tristanvandeweg/z80/z80/Plots/pcb/pcbProgress.png

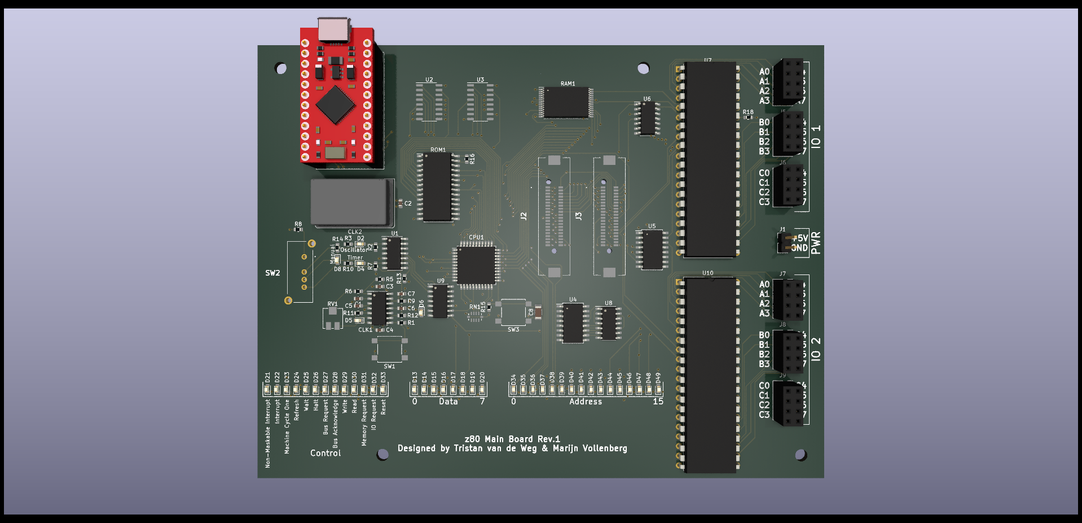
z80/Plots/pcb/pcbProgress.png
