tristanvandeweg/z80/README.md

# z80

Our awesome z80 computer!
<br />
# This project is still a work in progress
