tristanvandeweg/z80/img/pyprogui.png

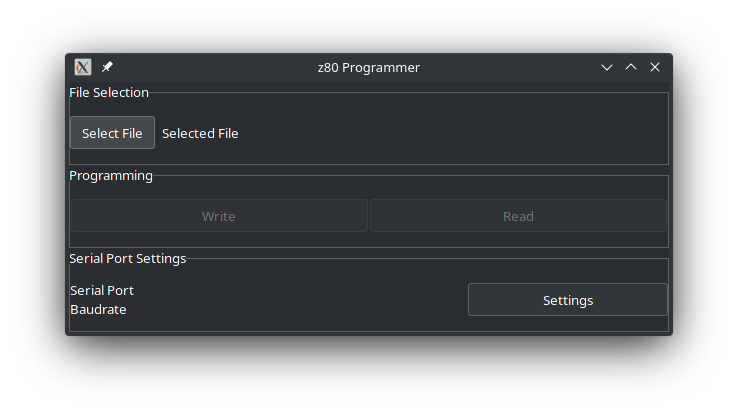
img/pyprogui.png
