tristanvandeweg/z80/img/pyprogui_readout.png

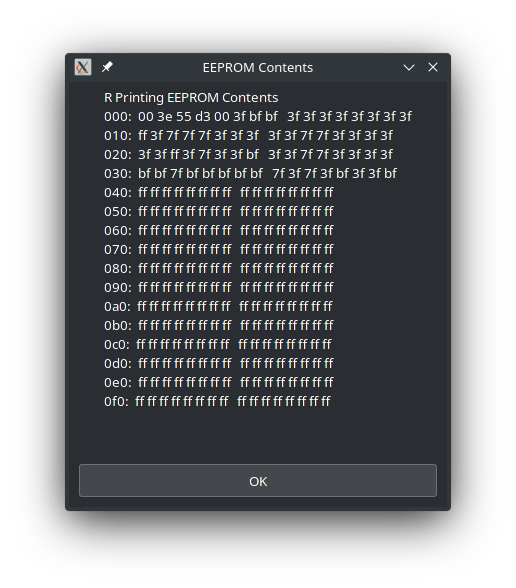
img/pyprogui_readout.png
