tristanvandeweg/z80/img/pyprogui_settings.png

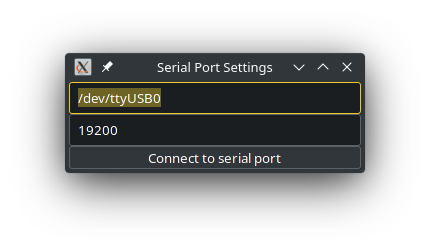
img/pyprogui_settings.png
