tristanvandeweg/z80/src/asm/test/.ticks_history.txt

reg
help
reg
quit
reg
stepi
reg
stepi
reg
stepi
reg
stepi
reg
quit
reg
stepi
reg
stepi
reg
stepi
reg
stepi
reg
stepi
reg
quit
reg
quit
reg
help
set a 36
set b 1f
reg
set a $36
reg
set b $1f
reg
stepi
reg
quit
set a $36
set b $1f
stepi
reg
quit
reg
quit
reg
quit
set b $36
set c $1f
stepi
reg
stepi
reg
stepi
reg
stepi
reg
quit
help
profiler -i
backtrace
stepi
backtrace
frame
frame 1
help
quit
reg
stepi
reg
stepi
reg
quit
reg
quit
nexti
reg
quit
nexti
reg
nexti
quit
nexti
reg
nexti
reg
nexti
reg
quit
reg
stepi
reg
quit
reg
help
x 0000
quit
x
