tristanvandeweg/z80/z80/Plots/schematic/z80.pdf

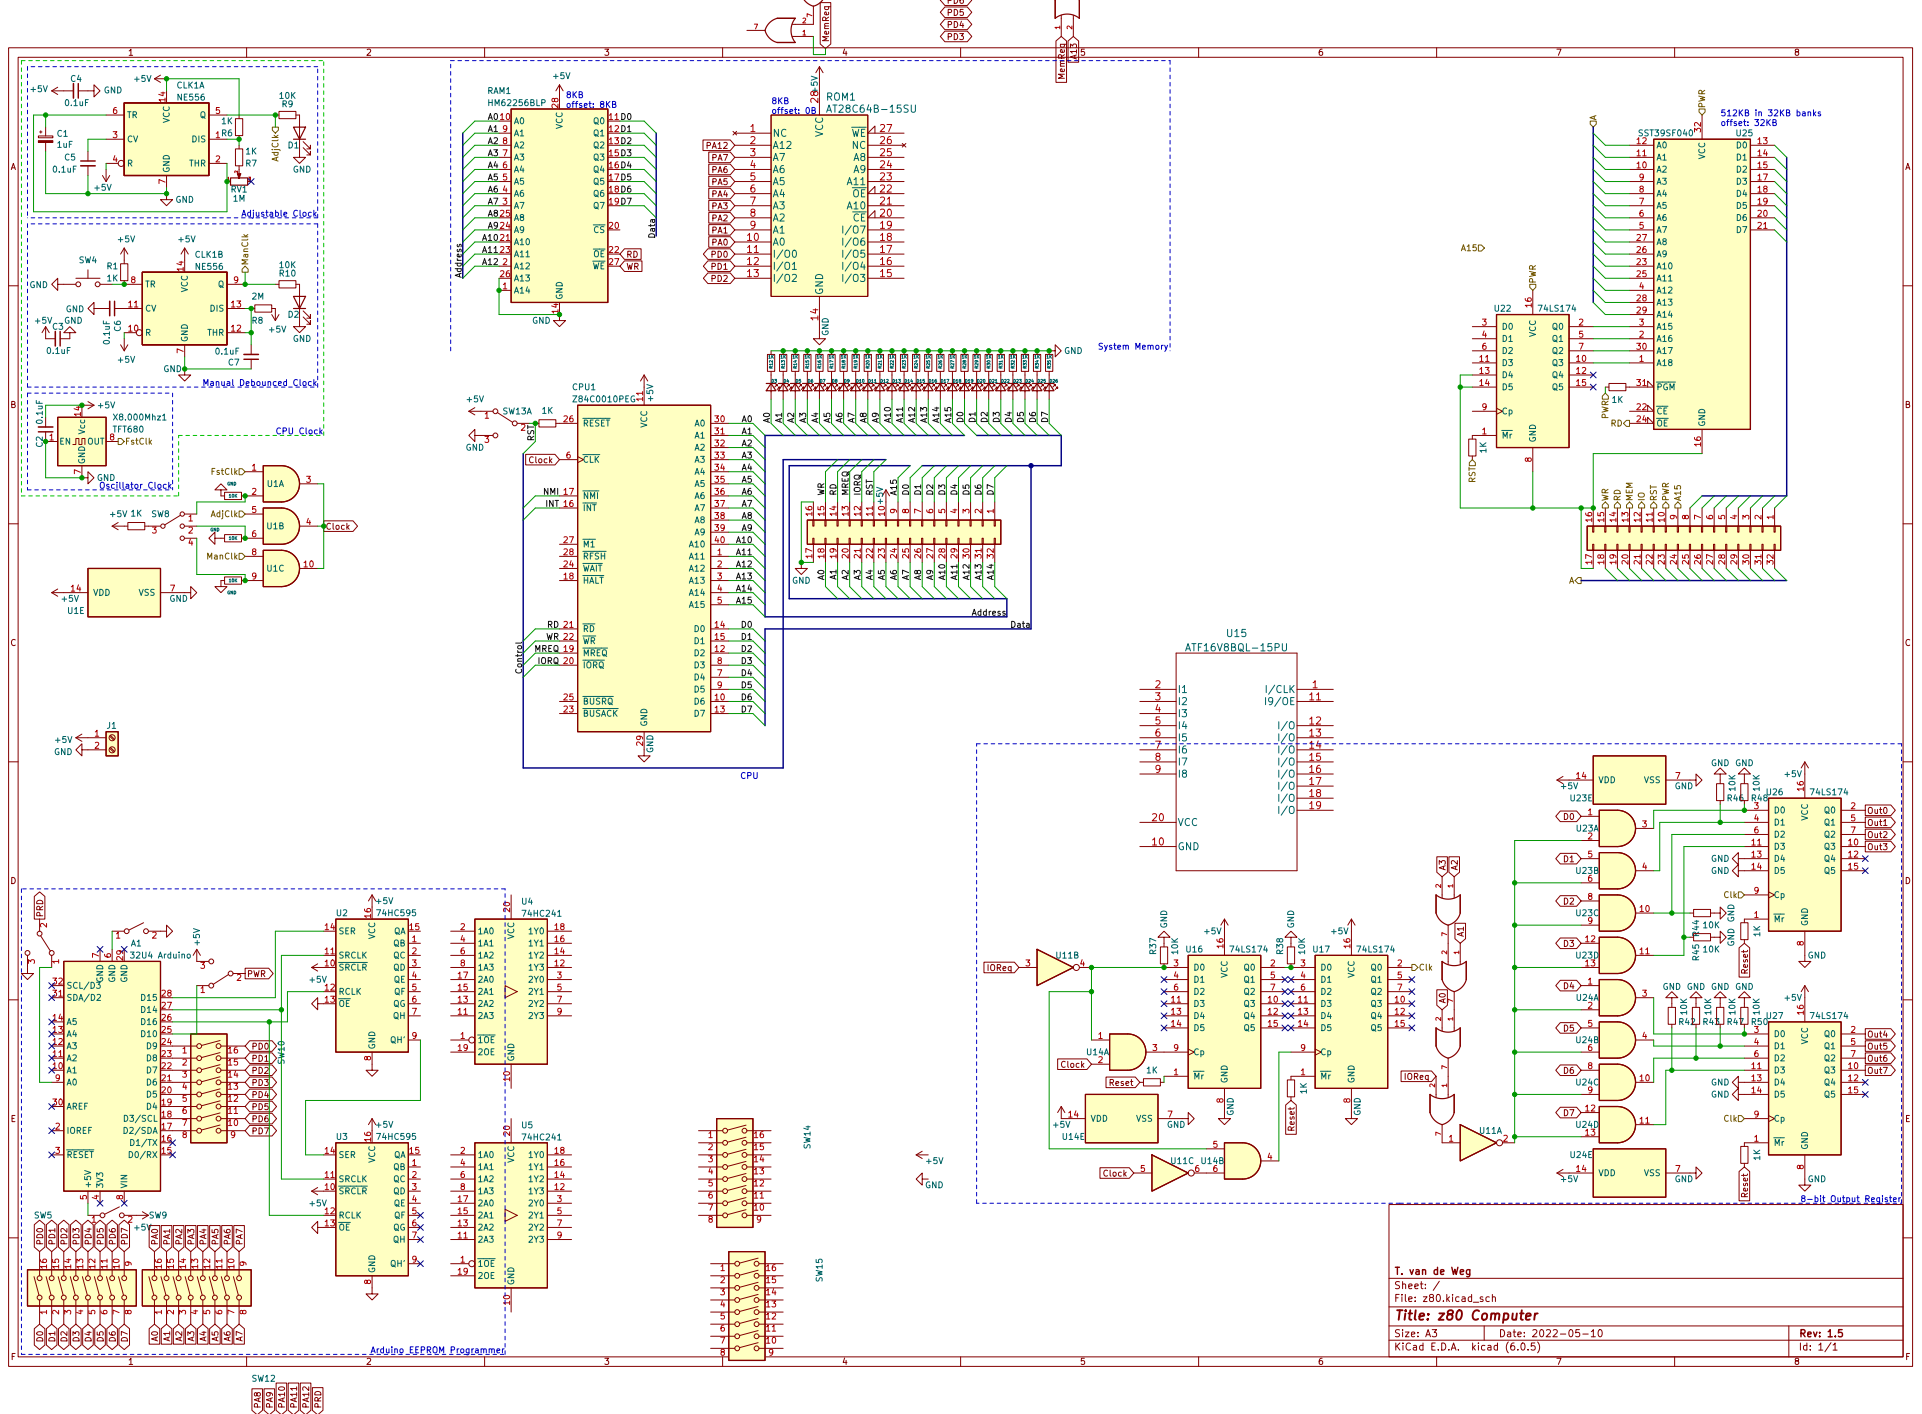
[picture p5: page 1]

1K GND
offset: 8KB CPU Clock Oscillator Clock

Manual Debounced Clock Clock Switching

5 | 12
6 | 11
7 | 10

File: z80.kicad_sch Sheet: / T. van de Weg
