tristanvandeweg/z80/z80/Plots/schematic/z80 (2.0).pdf

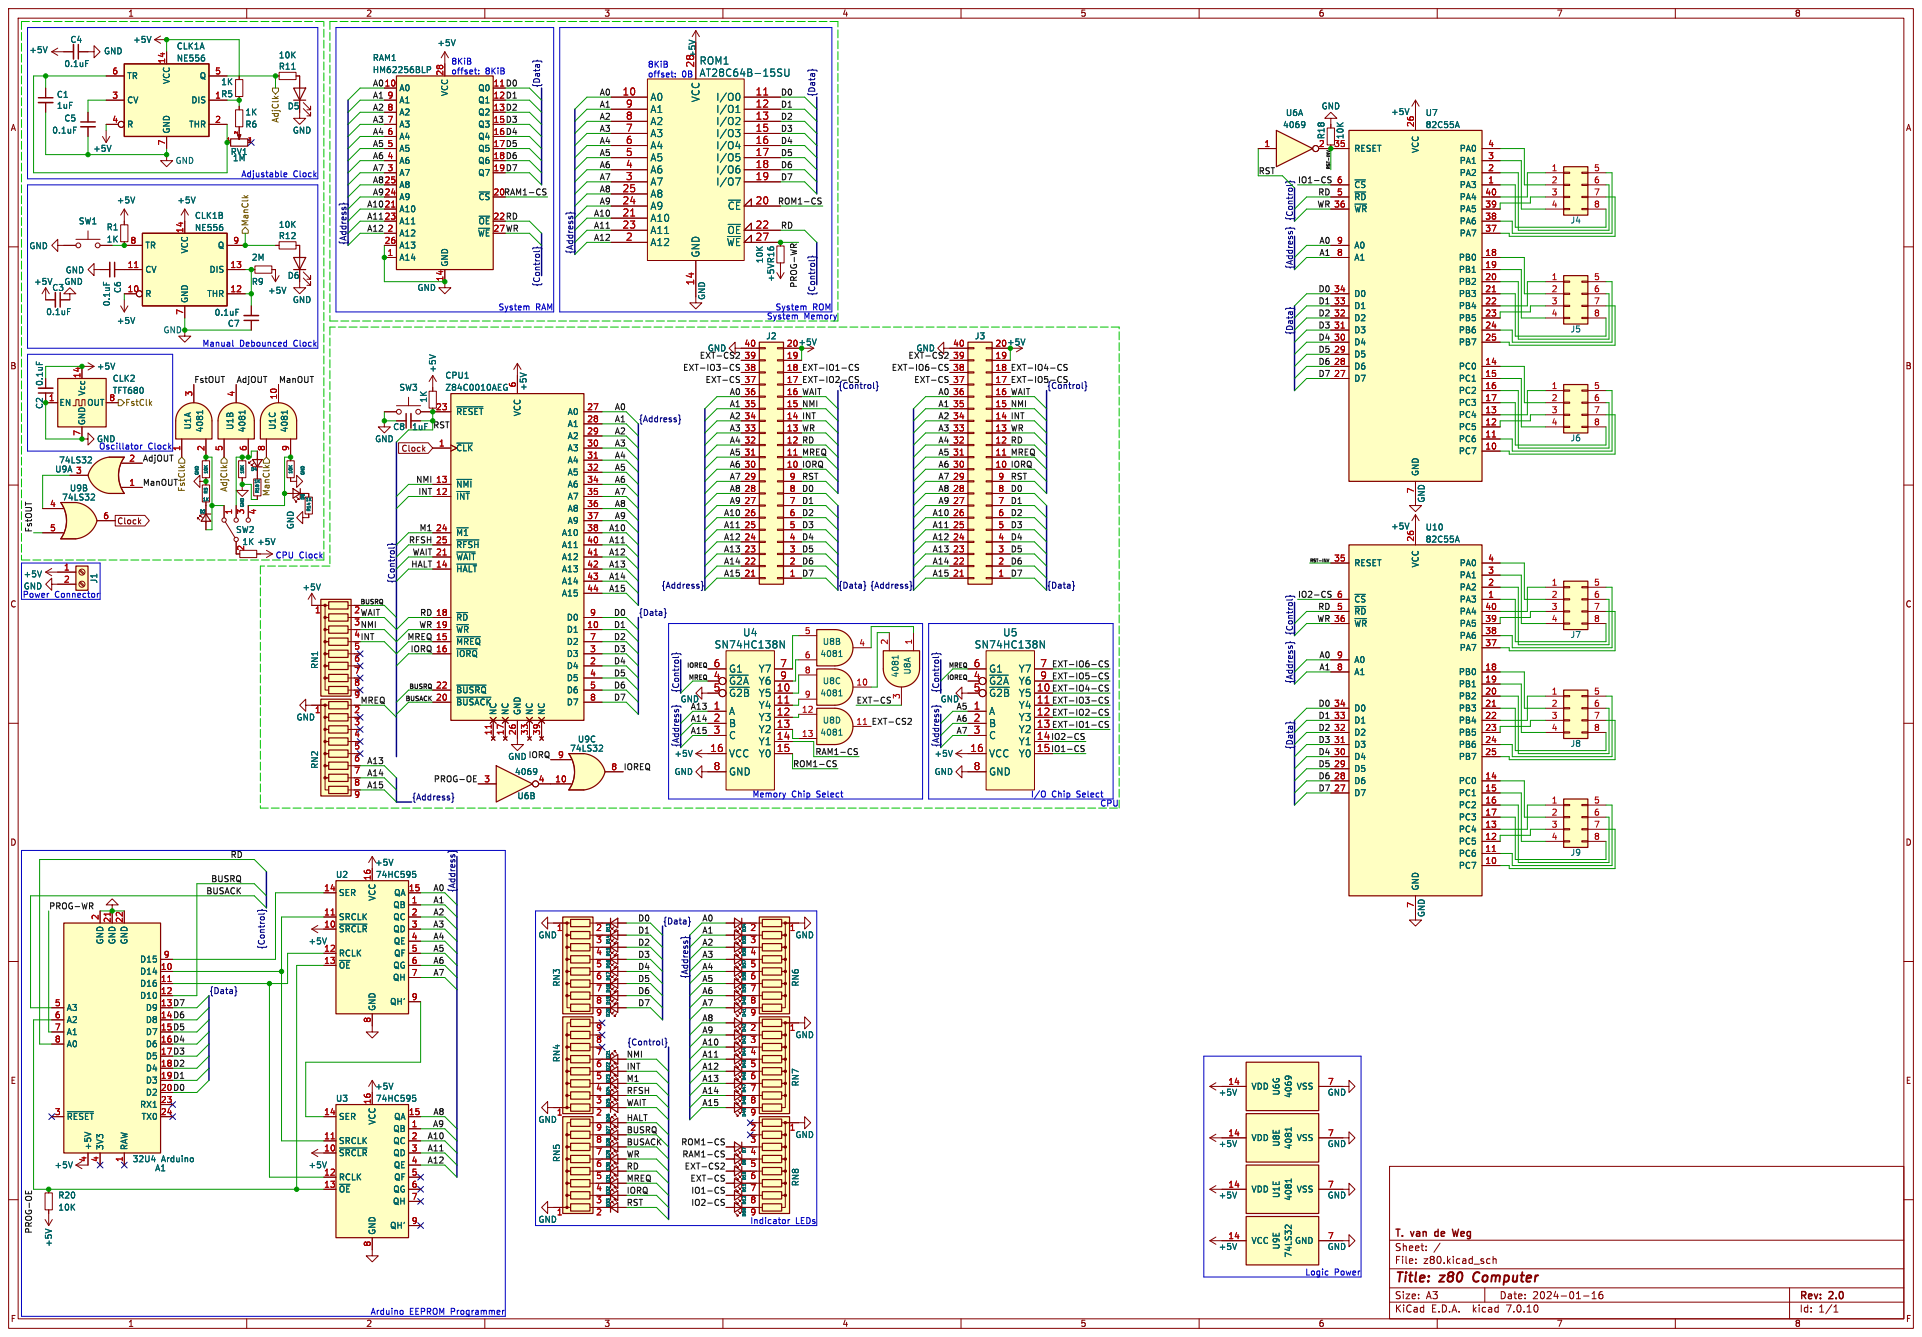
[picture p6: page 1]

CPU1 Z84C0010AEG
RST RFSH WAIT NMI
