tristanvandeweg/z80/z80/Plots/schematic/z80(1.9).pdf

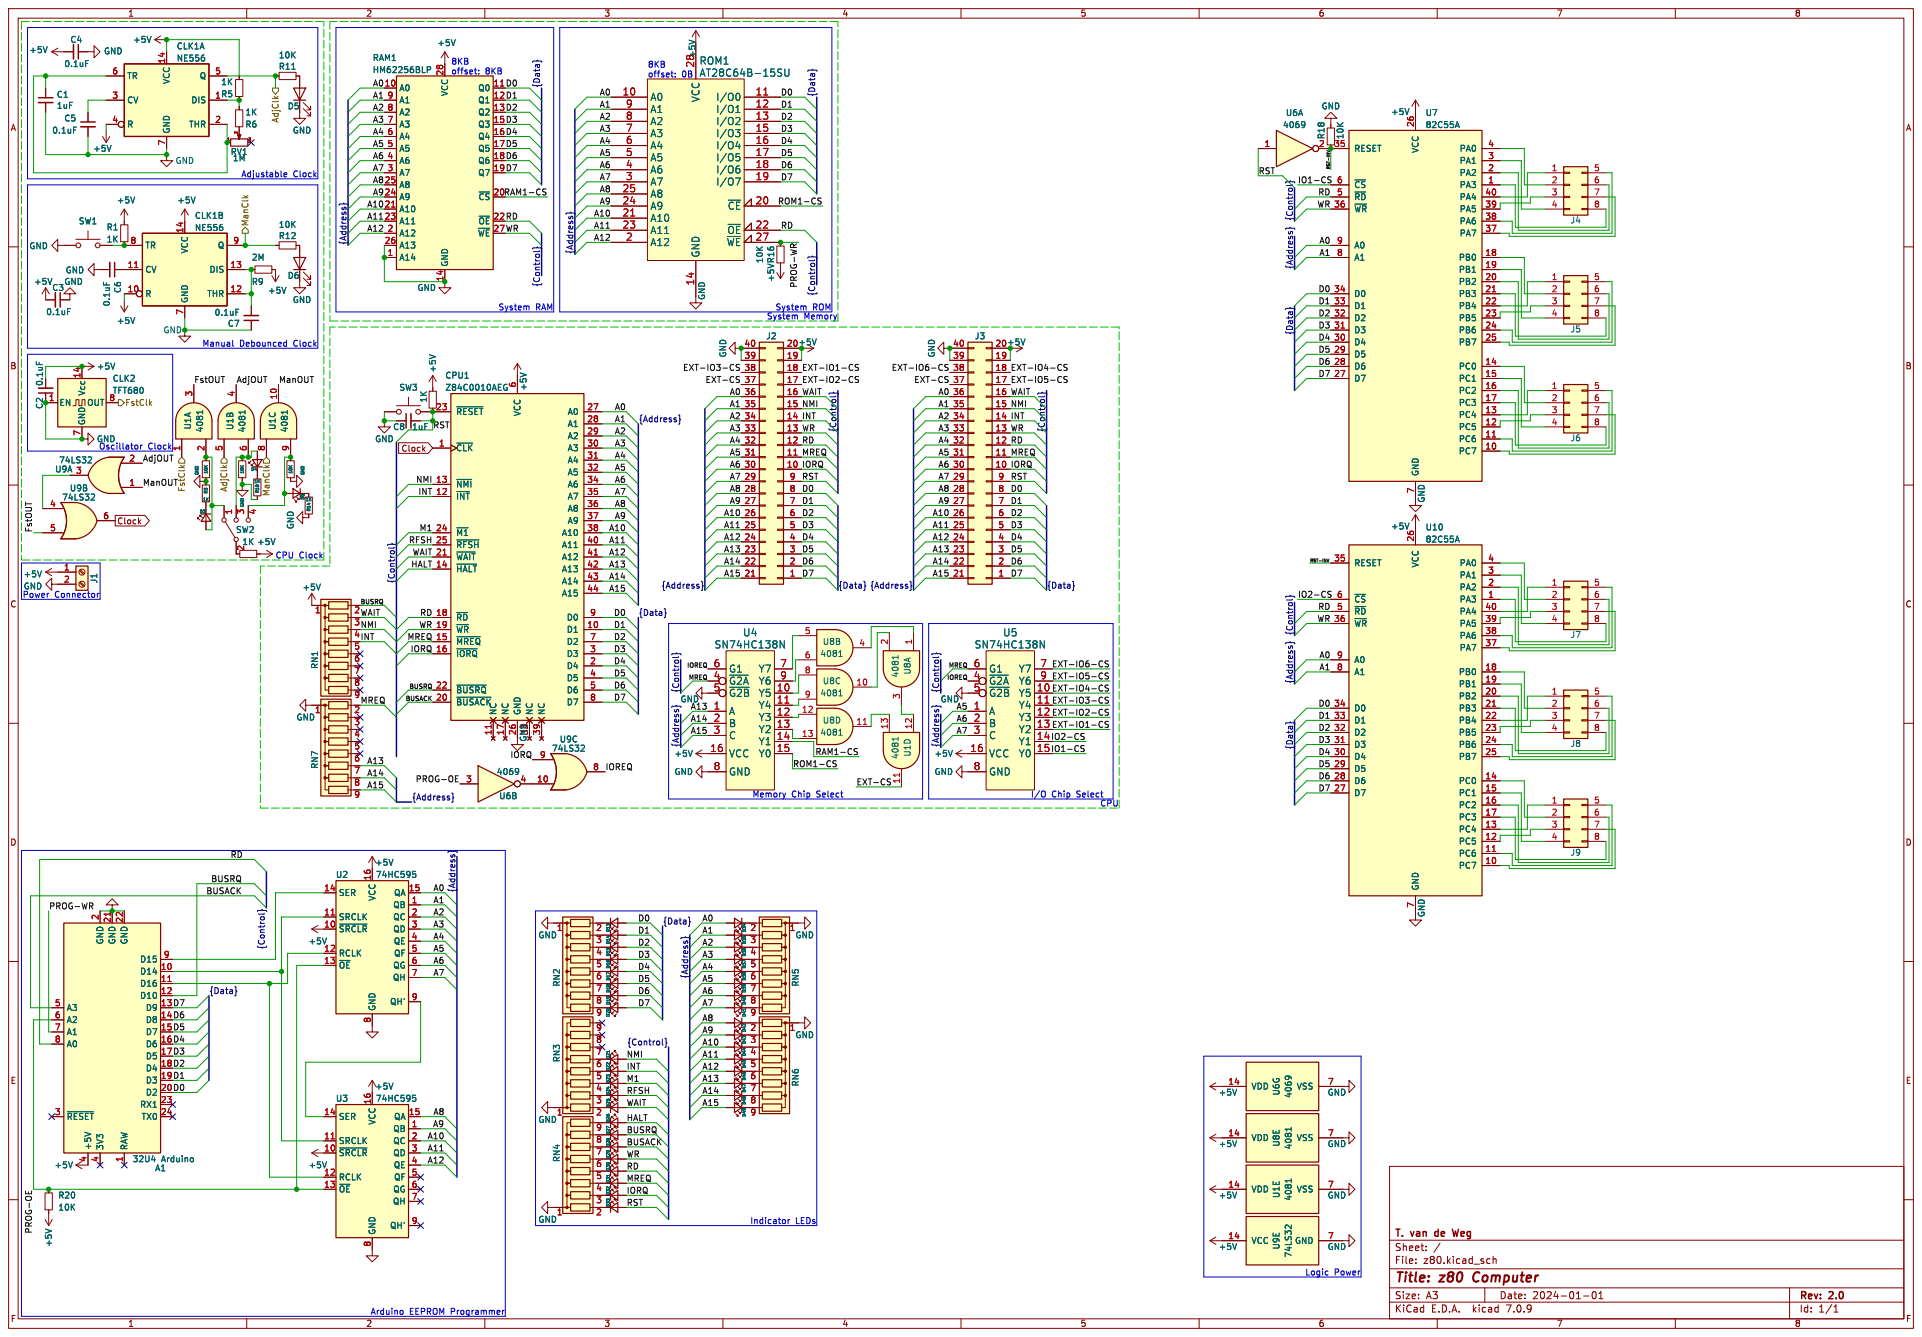
[picture p7: page 1]
