tristanvandeweg/z80/z80/Plots/schematic/output.pdf

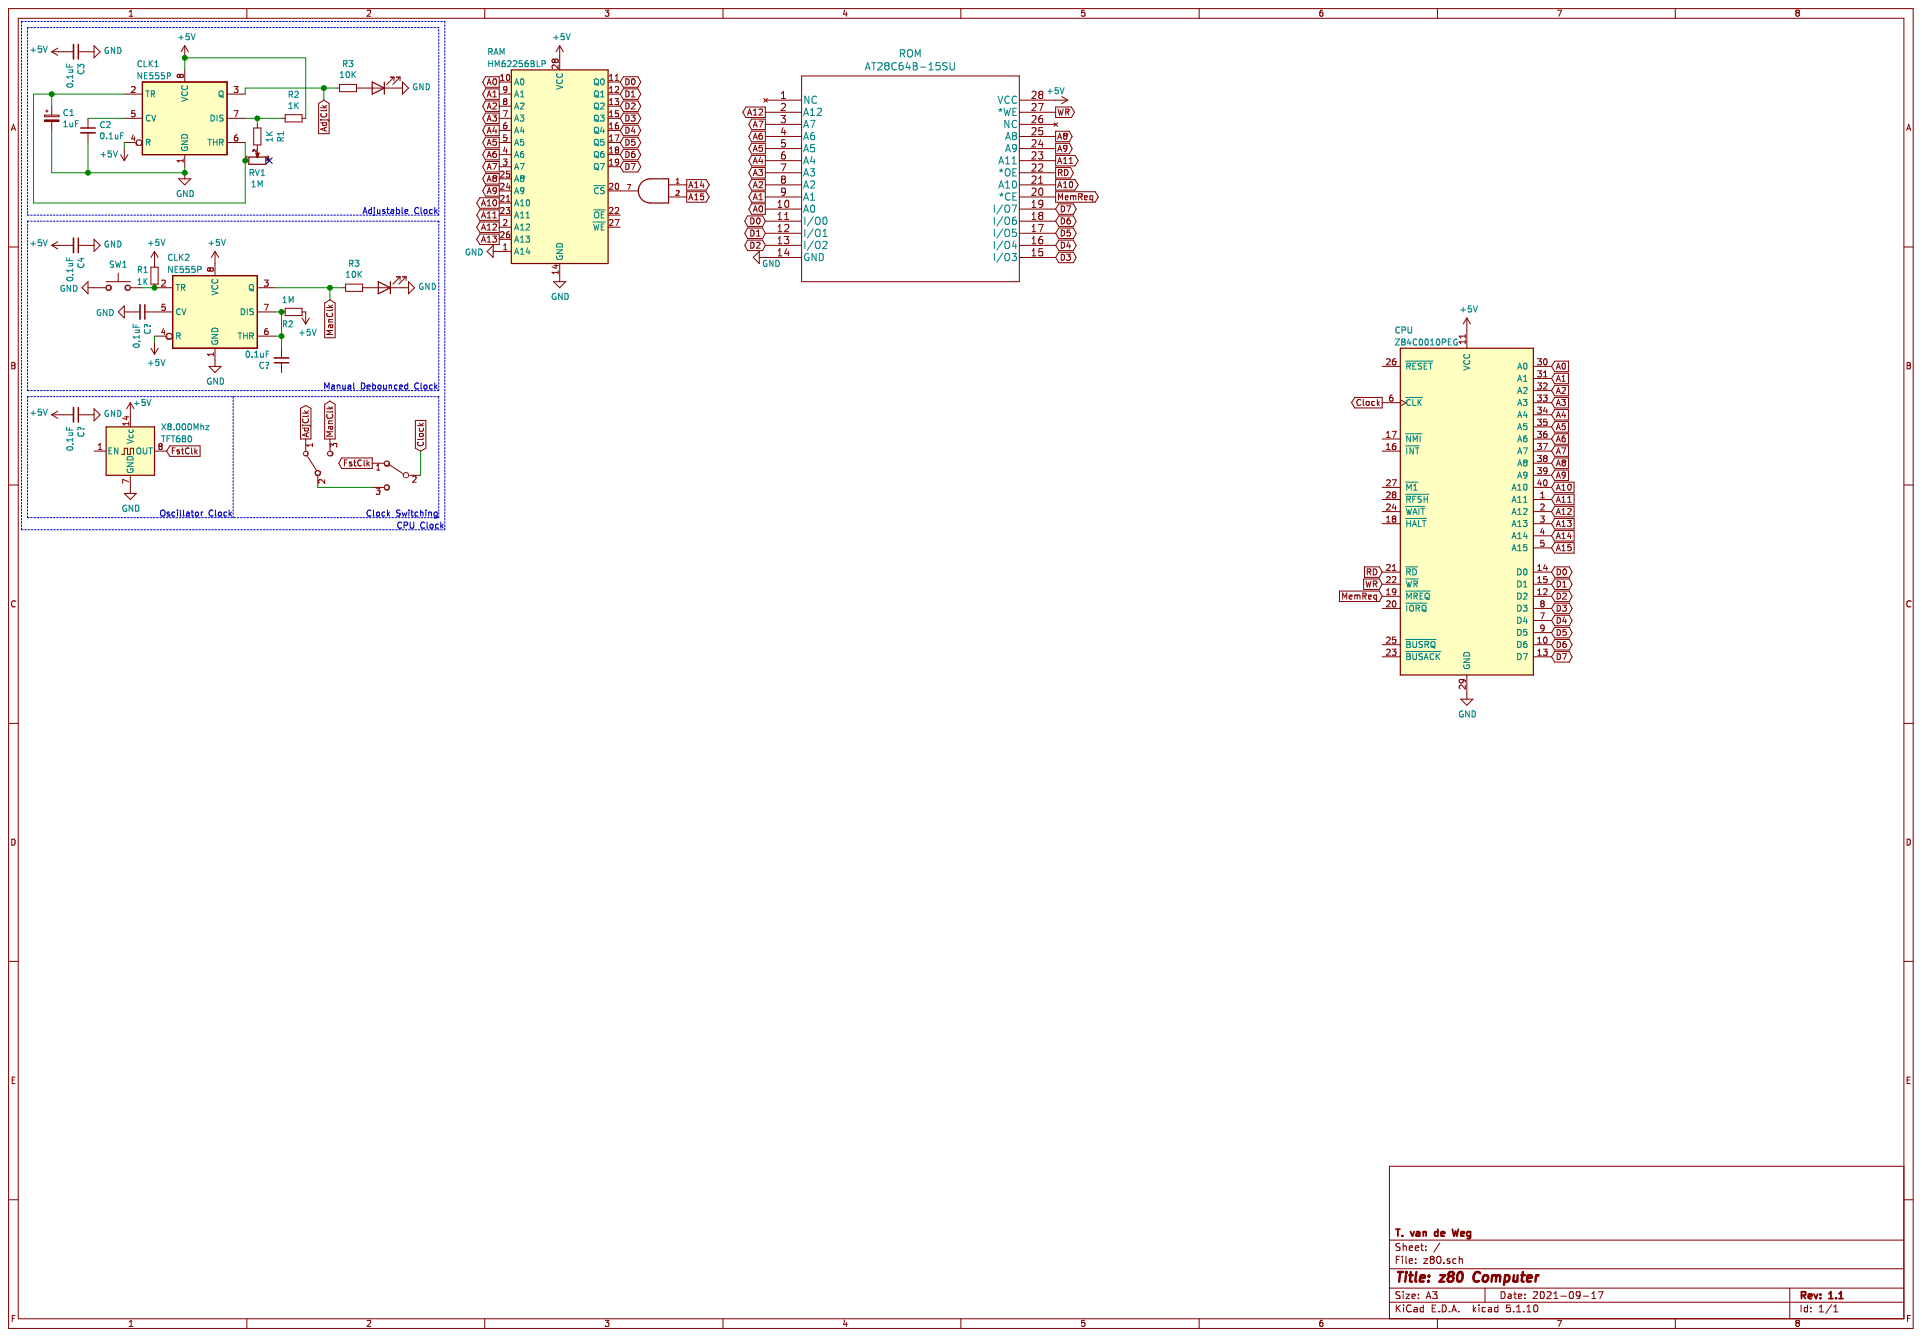
[picture p8: page 1]
