tristanvandeweg/z80/z80/Plots/schematic/z80Computer-v0.1-v1.1.pdf

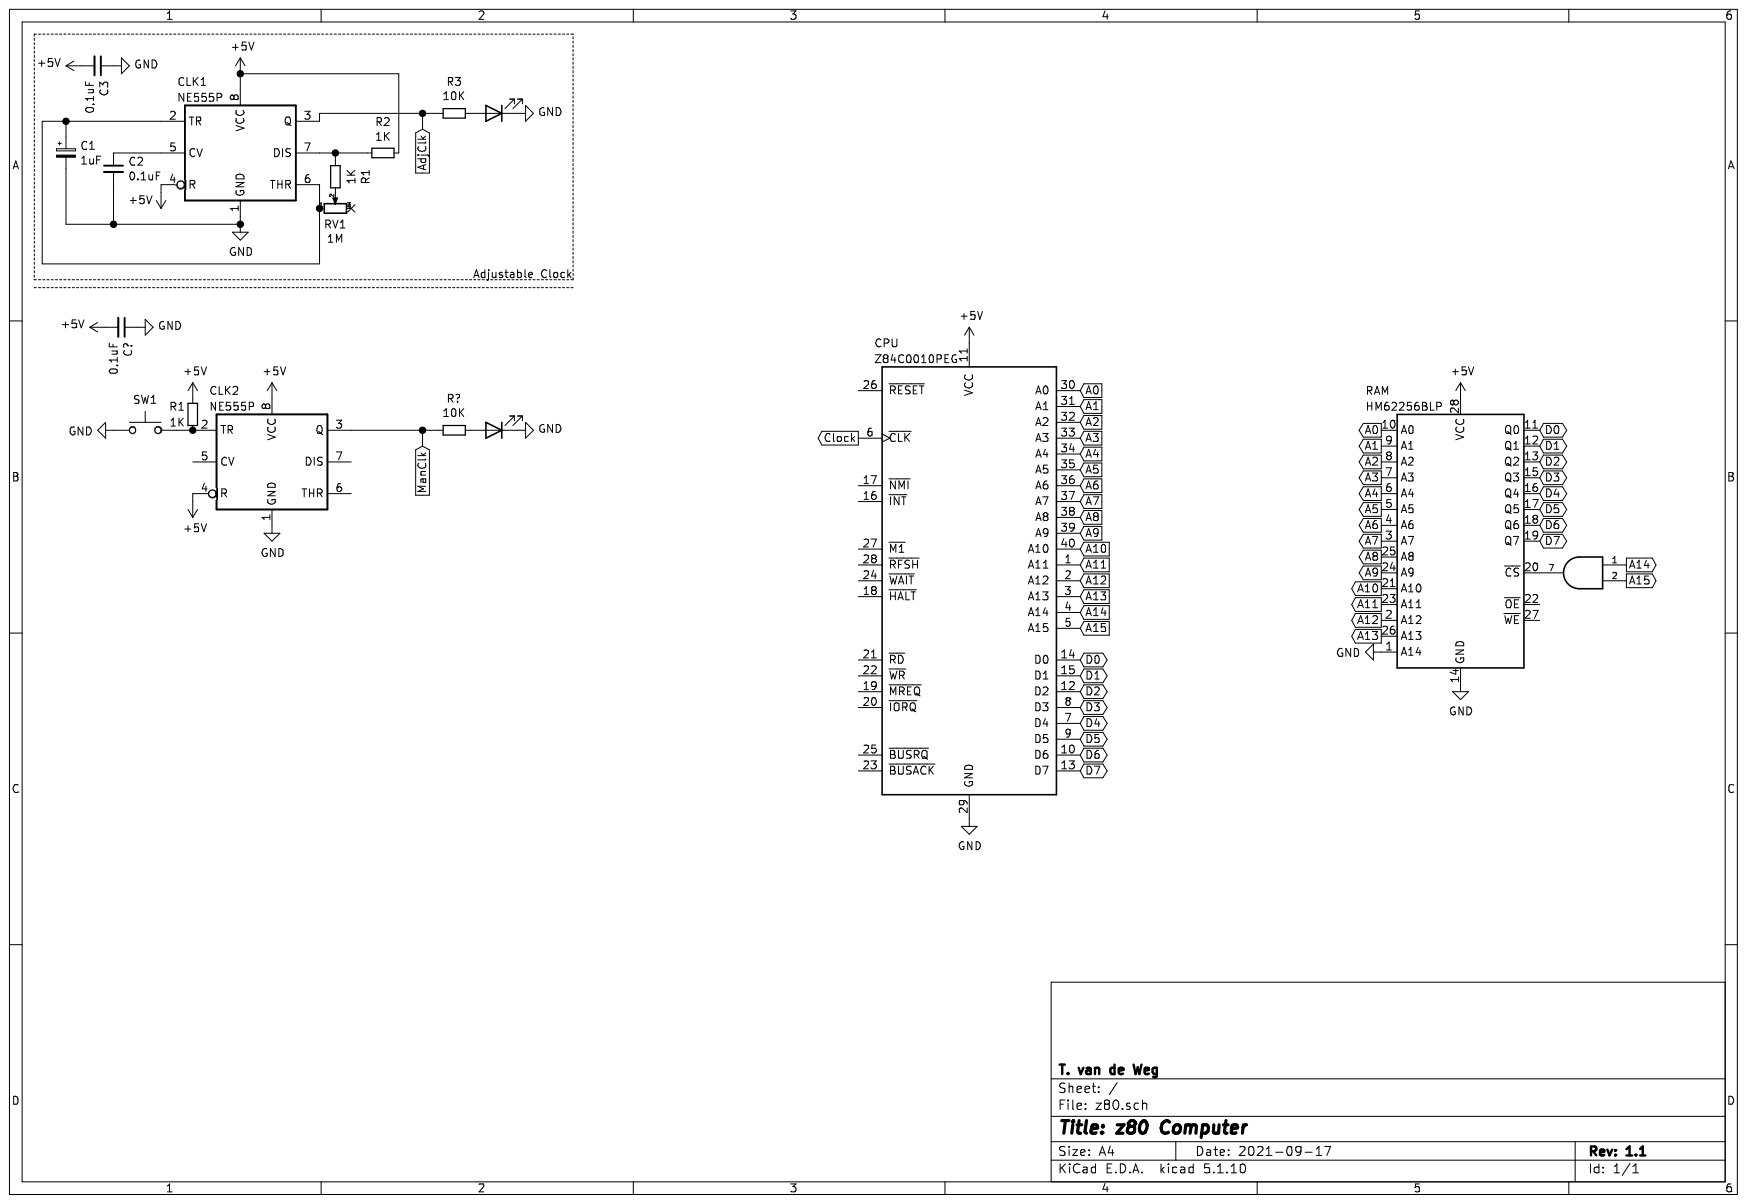
[picture p9: page 1]
