tristanvandeweg/z80/z80/Plots/schematic/z80Computer-v0.2.pdf

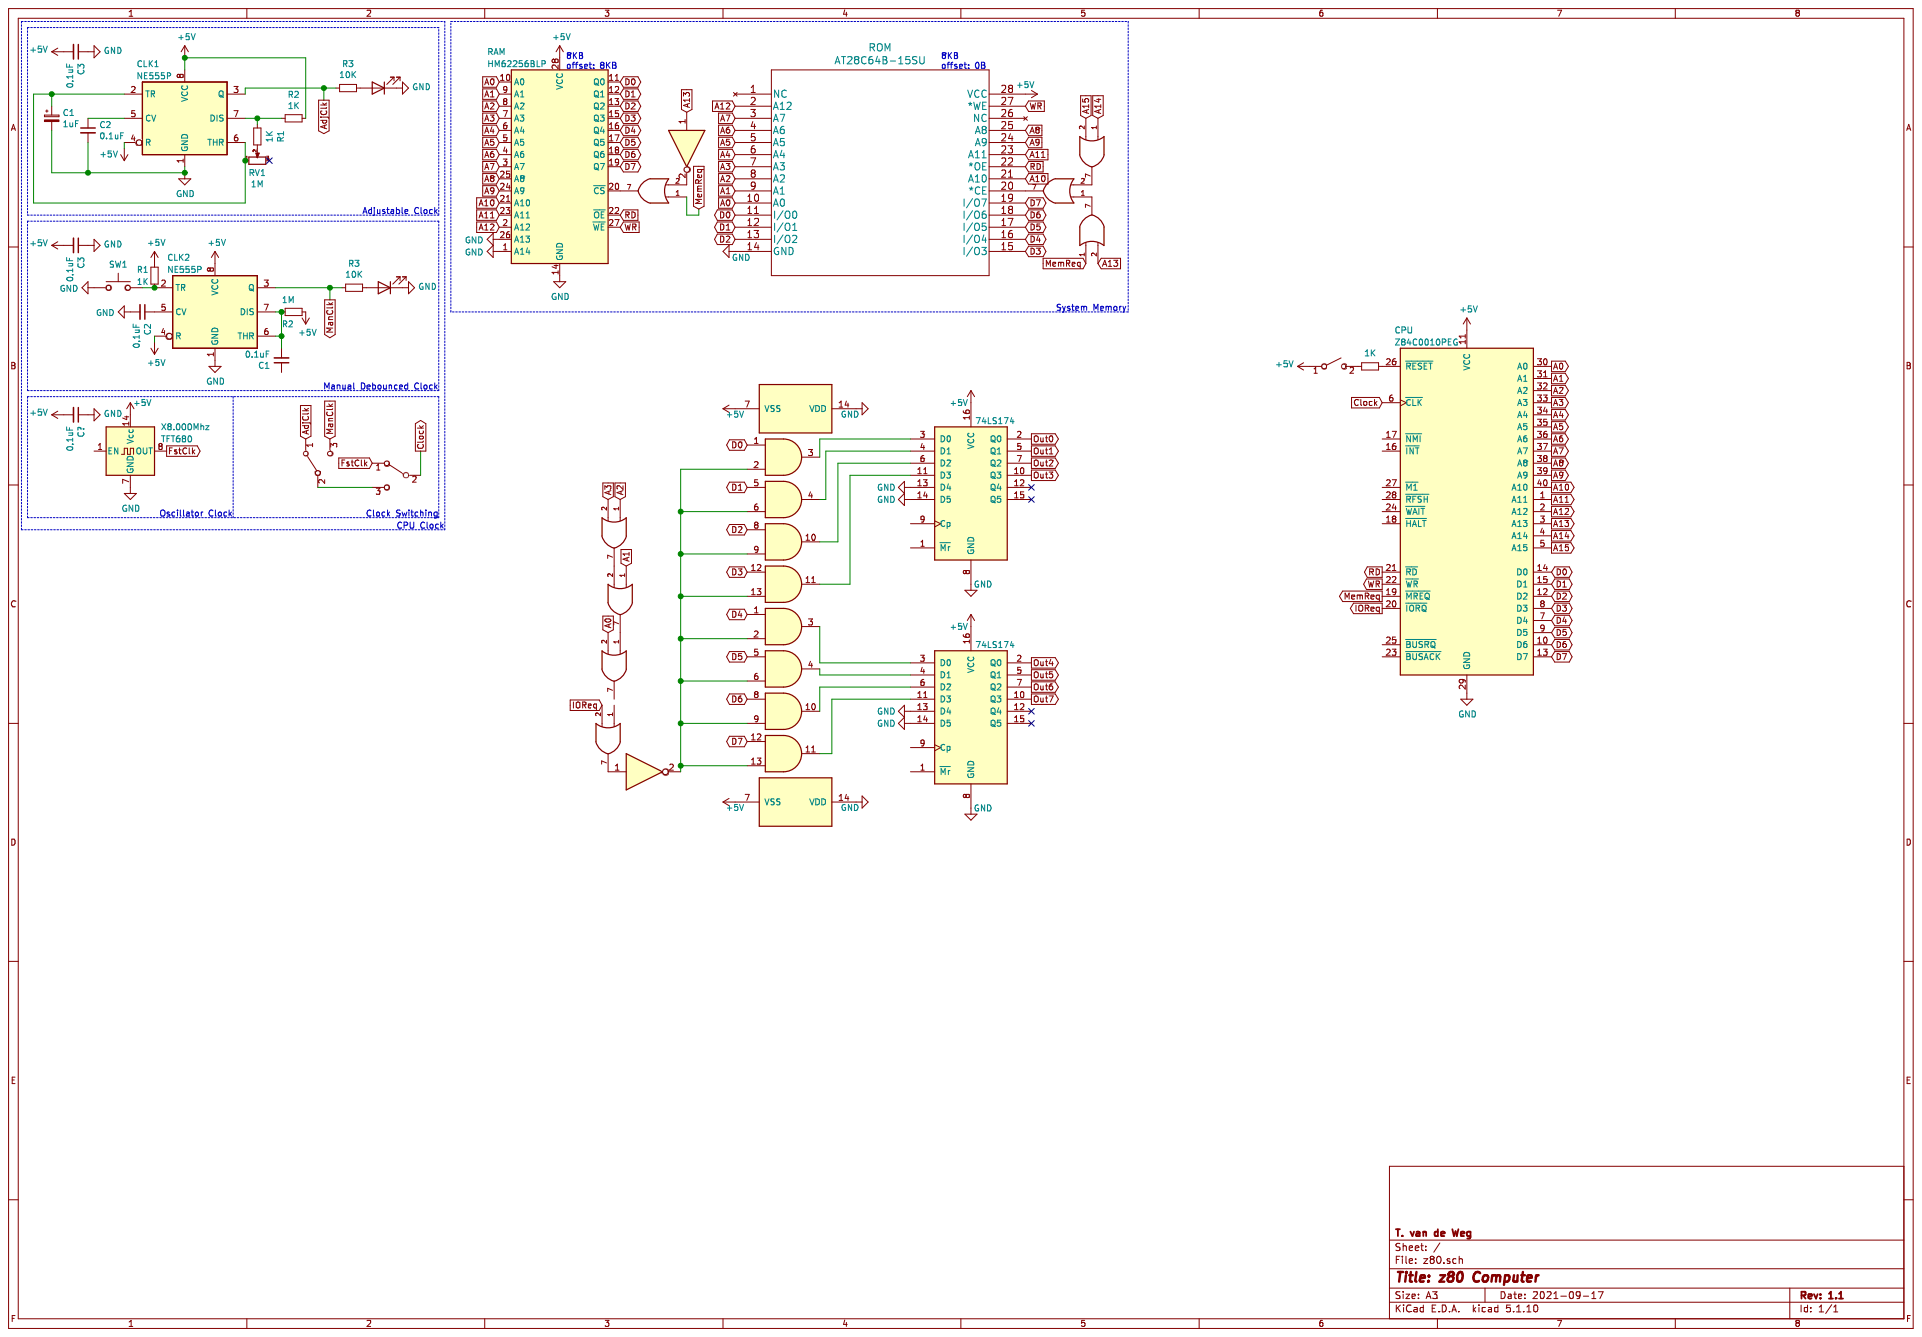
[picture p10: page 1]
