tristanvandeweg/z80/z80/Plots/schematic/z80R1.0Clk.pdf

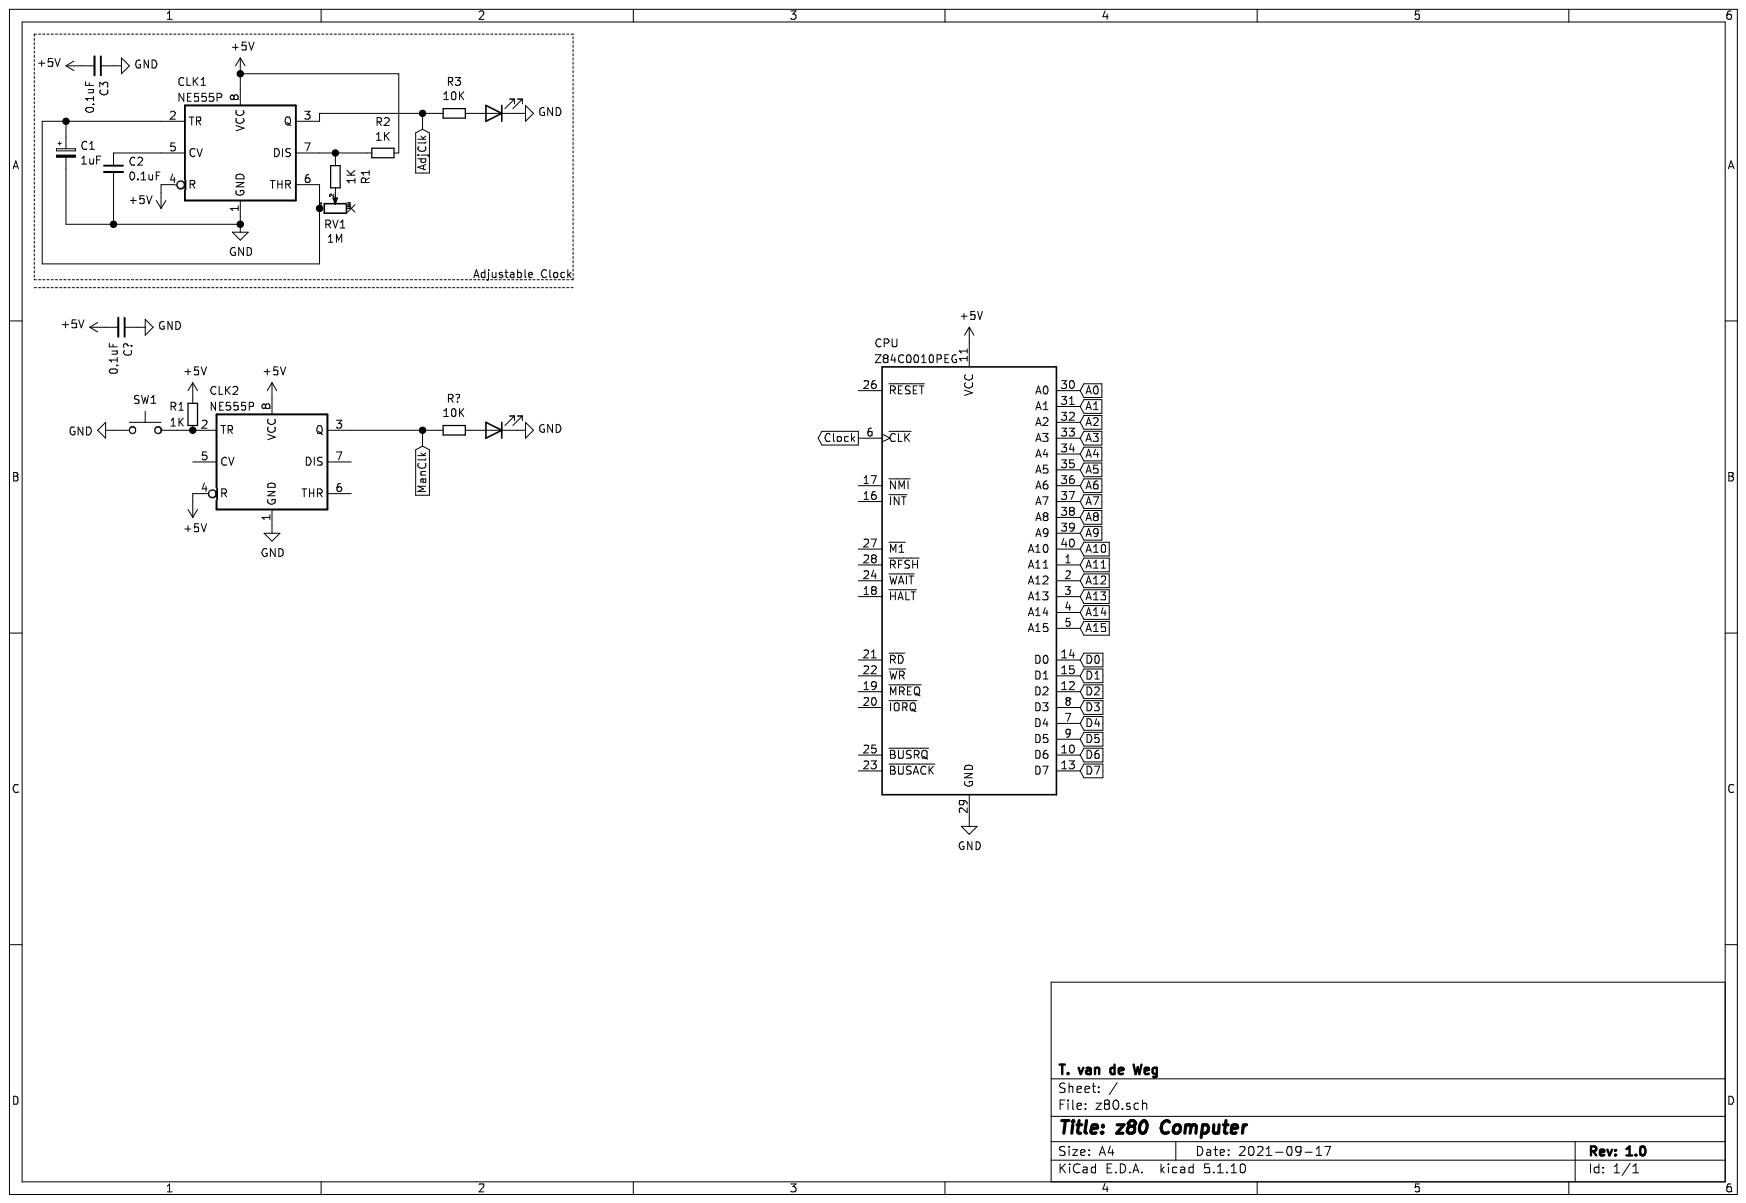
[picture p11: page 1]
