tristanvandeweg/z80/z80/Plots/schematic/z80 (1).pdf

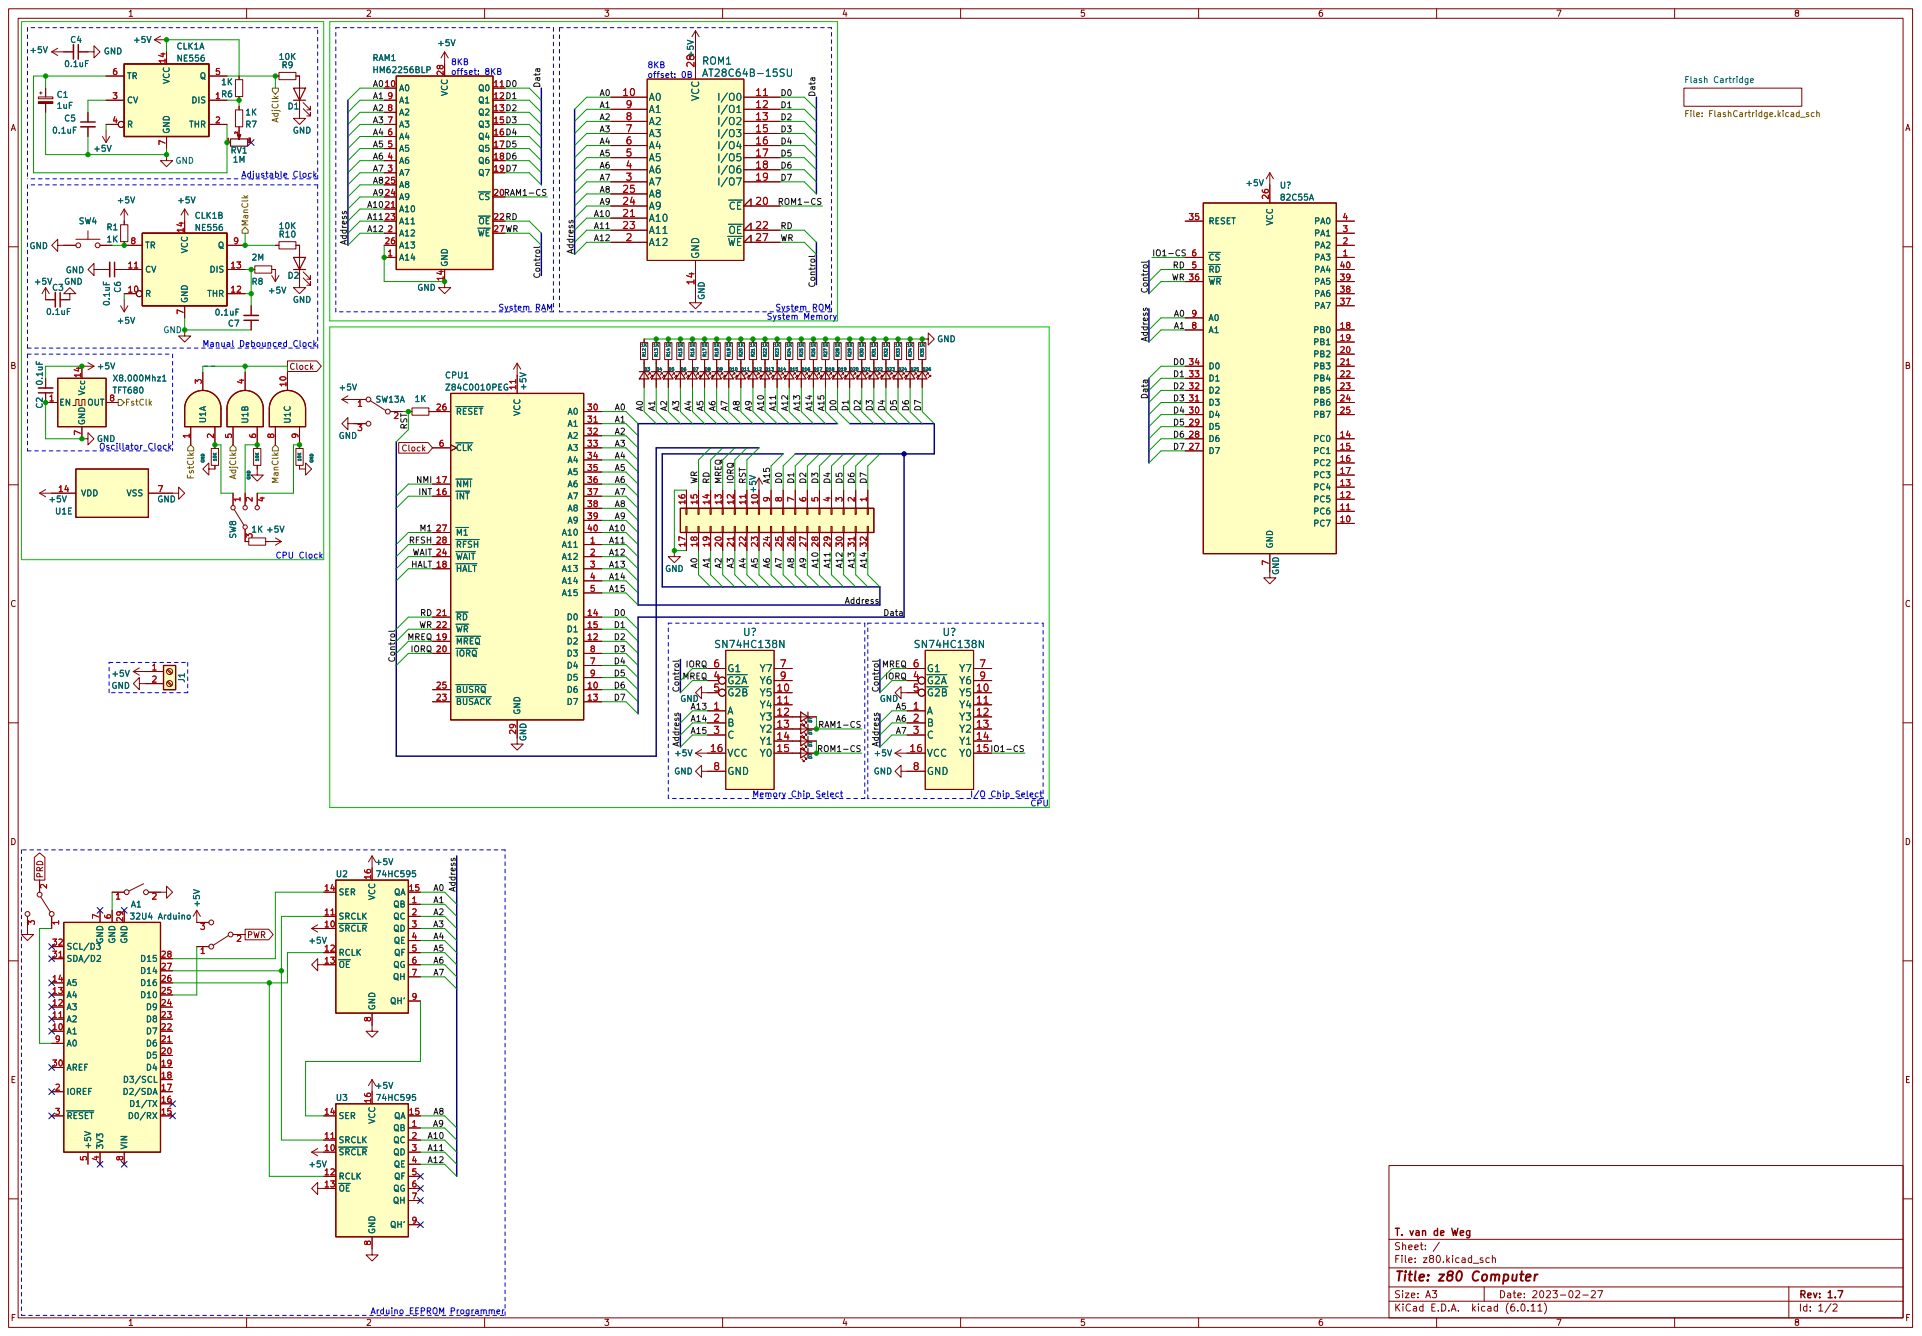
[picture p12: page 1]

Flash Cartridge File: FlashCartridge.kicad_sch R24
25 VCC 26 D7

I/O Chip Select Arduino EEPROM Programmer

Id: 1/2 Title: z80 Computer File: z80.kicad_sch Sheet: / T. van de Weg
