tristanvandeweg/z80/z80/Peripherals/ROM_Card/ROM_Card.kicad_pcb

## KiCad design z80/Peripherals/ROM_Card/ROM_Card.kicad_pcb (2024-03-15)

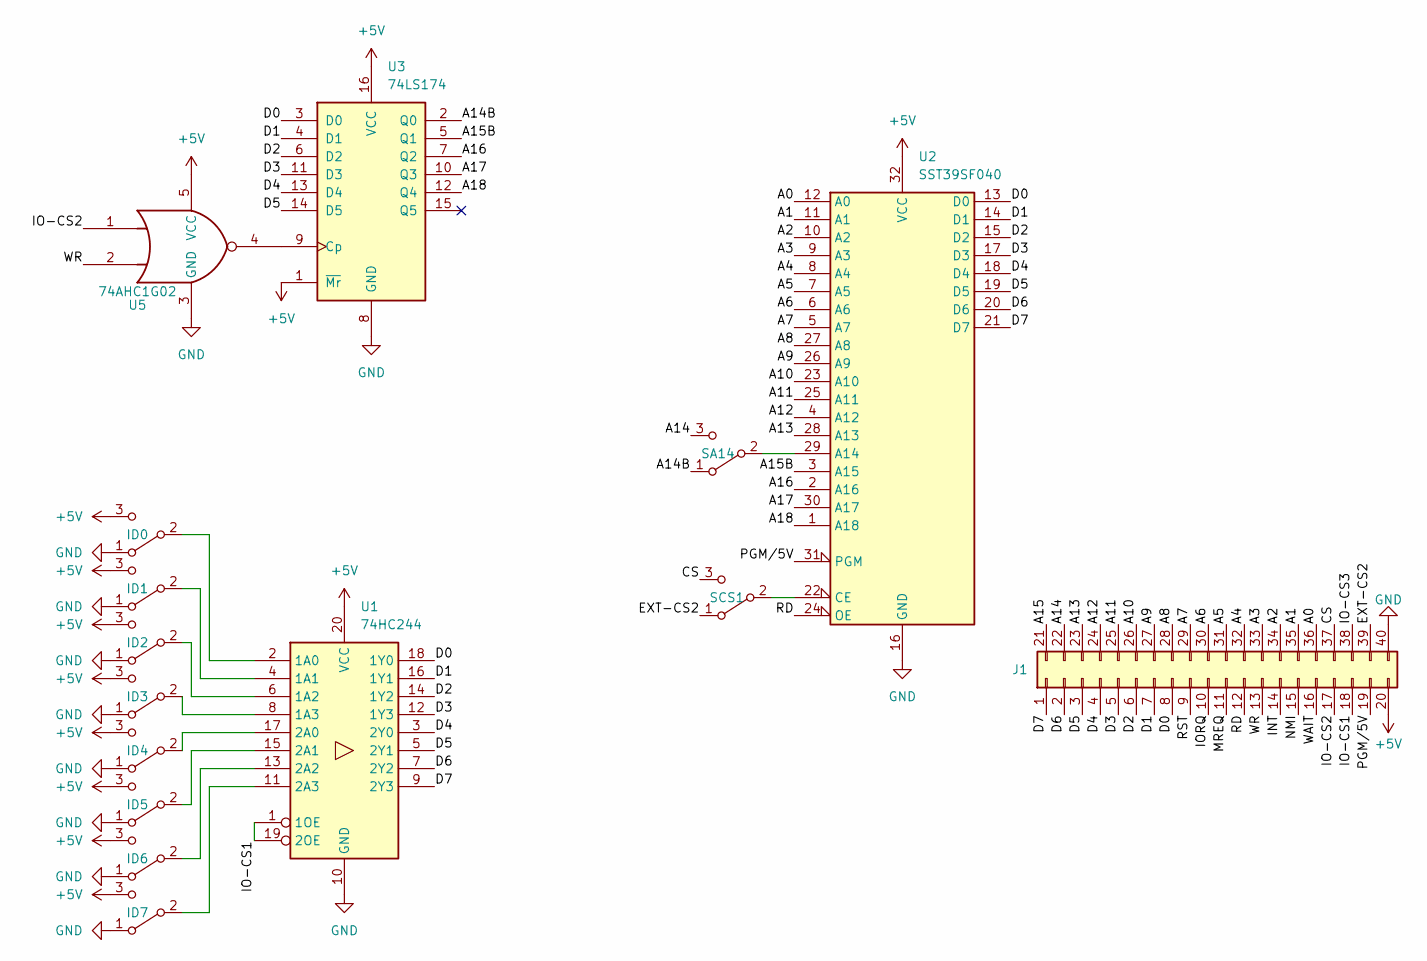
[picture p13: schematic ROM_Card.kicad_sch, z80 ROM Card]

Parts:
ID0, ID1, ID2, ID3, ID4, ID5, ID6, ID7: SW_SPDT; SolderJumper-3_P1.3mm_Open_Pad1.0x1.5mm
J1: Conn_02x20_Top_Bottom; 40-pin-edgeconnector
SA14: SW_SPDT; SolderJumper-3_P1.3mm_Open_Pad1.0x1.5mm
SCS1: SW_SPDT; SolderJumper-3_P1.3mm_Open_Pad1.0x1.5mm
U1: 74HC244; TSSOP-20_4.4x6.5mm_P0.65mm
U2: SST39SF040; PLCC-32_THT-Socket
U3: 74LS174; TSSOP-16_4.4x5mm_P0.65mm
U5: 74AHC1G02; SOT-553

Connections:
+5V: ID0.3 (C), ID1.3 (C), ID2.3 (C), ID3.3 (C), ID4.3 (C), ID5.3 (C), ID6.3 (C), ID7.3 (C), J1.20, U1.20 (VCC), U2.32 (VCC), U3.1 (~Mr), U3.16 (VCC), U5.5 (VCC)
/A0: J1.36, U2.12 (A0)
/A1: J1.35, U2.11 (A1)
/A2: J1.34, U2.10 (A2)
/A3: J1.33, U2.9 (A3)
/A4: J1.32, U2.8 (A4)
/A5: J1.31, U2.7 (A5)
/A6: J1.30, U2.6 (A6)
/A7: J1.29, U2.5 (A7)
/A8: J1.28, U2.27 (A8)
/A9: J1.27, U2.26 (A9)
/A10: J1.26, U2.23 (A10)
/A11: J1.25, U2.25 (A11)
/A12: J1.24, U2.4 (A12)
/A13: J1.23, U2.28 (A13)
/A14: J1.22, SA14.3 (C)
/A14B: SA14.1 (A), U3.2 (Q0)
/A15: J1.21
/A15B: U2.3 (A15), U3.5 (Q1)
/A16: U2.2 (A16), U3.7 (Q2)
/A17: U2.30 (A17), U3.10 (Q3)
/A18: U2.1 (A18), U3.12 (Q4)
/CS: J1.37, SCS1.3 (C)
/D0: J1.8, U1.18 (1Y0), U2.13 (D0), U3.3 (D0)
/D1: J1.7, U1.16 (1Y1), U2.14 (D1), U3.4 (D1)
/D2: J1.6, U1.14 (1Y2), U2.15 (D2), U3.6 (D2)
/D3: J1.5, U1.12 (1Y3), U2.17 (D3), U3.11 (D3)
/D4: J1.4, U1.3 (2Y0), U2.18 (D4), U3.13 (D4)
/D5: J1.3, U1.5 (2Y1), U2.19 (D5), U3.14 (D5)
/D6: J1.2, U1.7 (2Y2), U2.20 (D6)
/D7: J1.1, U1.9 (2Y3), U2.21 (D7)
/EXT-CS2: J1.39, SCS1.1 (A)
/INT: J1.14
/IO-CS1: J1.18, U1.1 (1OE), U1.19 (2OE)
/IO-CS2: J1.17, U5.1
/IO-CS3: J1.38
/IORQ: J1.10
/MREQ: J1.11
/NMI: J1.15
/PGM/5V: J1.19, U2.31 (PGM)
/RD: J1.12, U2.24 (OE)
/RST: J1.9
/WAIT: J1.16
/WR: J1.13, U5.2
GND: ID0.1 (A), ID1.1 (A), ID2.1 (A), ID3.1 (A), ID4.1 (A), ID5.1 (A), ID6.1 (A), ID7.1 (A), J1.40, U1.10 (GND), U2.16 (GND), U3.8 (GND), U5.3 (GND)
unnamed: ID0.2 (B), U1.2 (1A0)
unnamed: ID1.2 (B), U1.4 (1A1)
unnamed: ID2.2 (B), U1.6 (1A2)
unnamed: ID3.2 (B), U1.8 (1A3)
unnamed: ID4.2 (B), U1.17 (2A0)
unnamed: ID5.2 (B), U1.15 (2A1)
unnamed: ID6.2 (B), U1.13 (2A2)
unnamed: ID7.2 (B), U1.11 (2A3)
unnamed: SA14.2 (B), U2.29 (A14)
unnamed: SCS1.2 (B), U2.22 (CE)
unnamed: U3.9 (Cp), U5.4

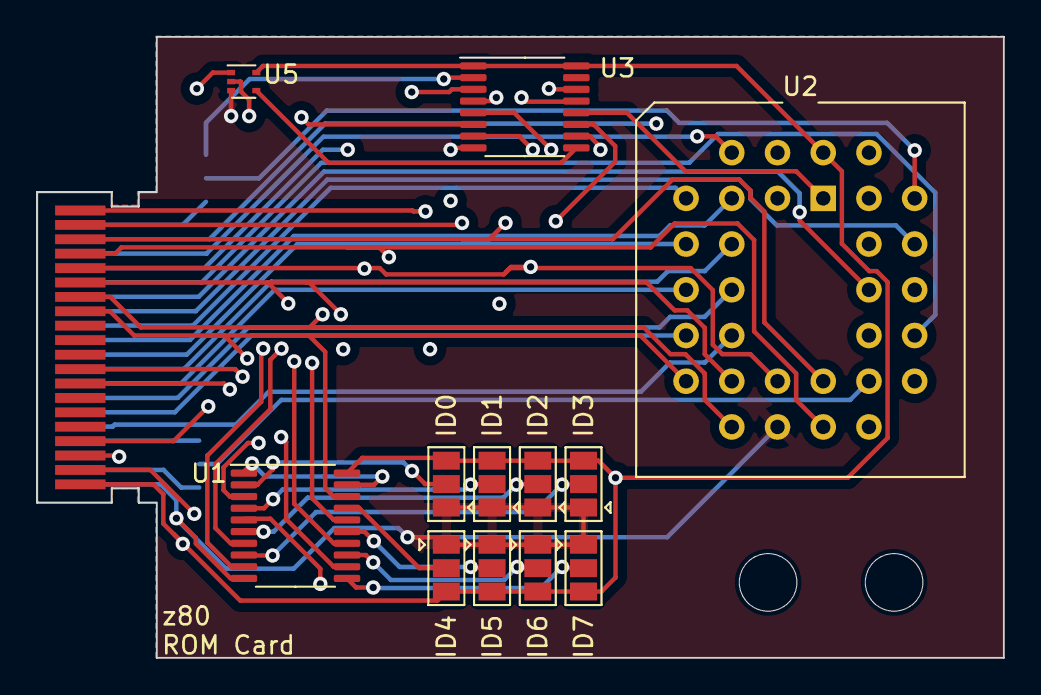
[picture p14: board ROM_Card.kicad_pcb from above]

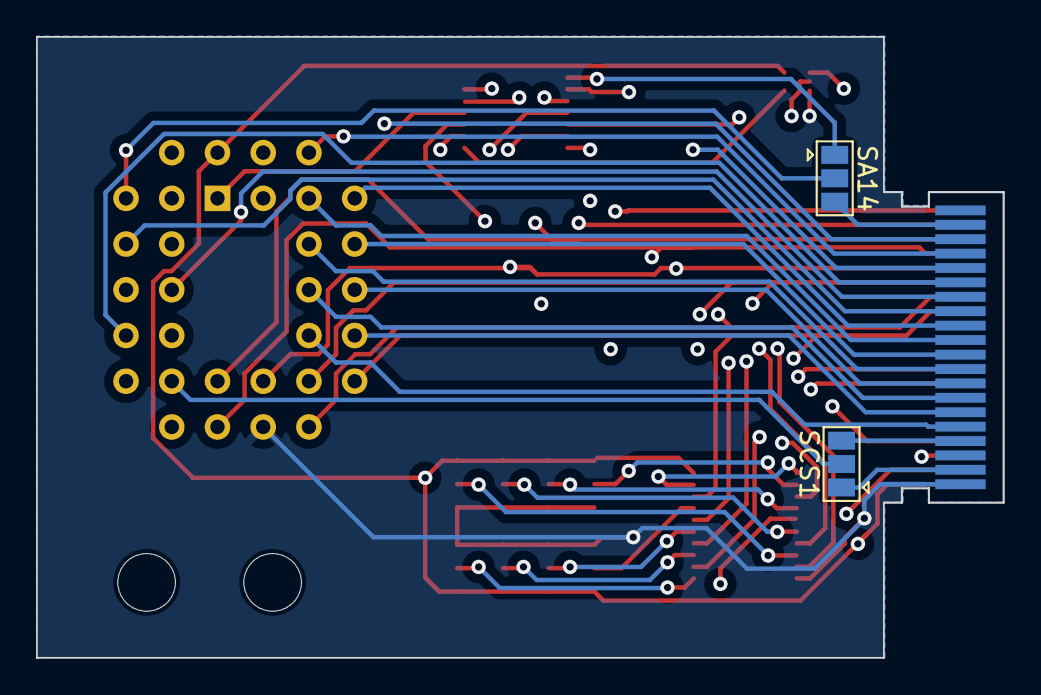
[picture p15: board ROM_Card.kicad_pcb from below]

Board: 4 copper layers, 53.7 x 34.5 mm, 15 parts (2 on the bottom side), 48 nets.
