tristanvandeweg/z80/z80/Peripherals/IO_LED_Stick/IO_LED_Stick.kicad_pcb

## KiCad design z80/Peripherals/IO_LED_Stick/IO_LED_Stick.kicad_pcb (2024-03-15)

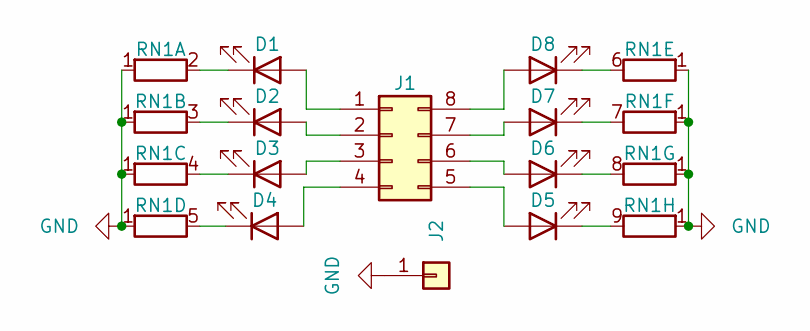
[picture p16: schematic IO_LED_Stick.kicad_sch]

Parts:
D1, D2, D3, D4, D5, D6, D7, D8: LED; LED_0603_1608Metric
J1: Conn_02x04_Counter_Clockwise; PinHeader_2x04_P2.54mm_Vertical
J2: Conn_01x01; PinHeader_1x01_P2.54mm_Vertical
RN1: R_Network08_Split; EXB-D10C103J

Connections:
GND: J2.1, RN1.1 (R1)
unnamed: D1.2 (A), J1.1
unnamed: D1.1 (K), RN1.2 (R1.2)
unnamed: D2.2 (A), J1.2
unnamed: D2.1 (K), RN1.3 (R2.2)
unnamed: D3.2 (A), J1.3
unnamed: D3.1 (K), RN1.4 (R3.2)
unnamed: D4.2 (A), J1.4
unnamed: D4.1 (K), RN1.5 (R4.2)
unnamed: D5.2 (A), J1.5
unnamed: D5.1 (K), RN1.9 (R8.2)
unnamed: D6.2 (A), J1.6
unnamed: D6.1 (K), RN1.8 (R7.2)
unnamed: D7.2 (A), J1.7
unnamed: D7.1 (K), RN1.7 (R6.2)
unnamed: D8.2 (A), J1.8
unnamed: D8.1 (K), RN1.6 (R5.2)

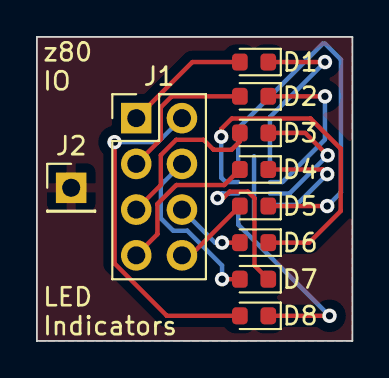
[picture p17: board IO_LED_Stick.kicad_pcb from above]

Board: 2 copper layers, 17.5 x 16.9 mm, 11 parts (1 on the bottom side), 17 nets.
