tristanvandeweg/z80/z80/z80.kicad_pcb

## KiCad design z80/z80.kicad_pcb (2024-01-03)

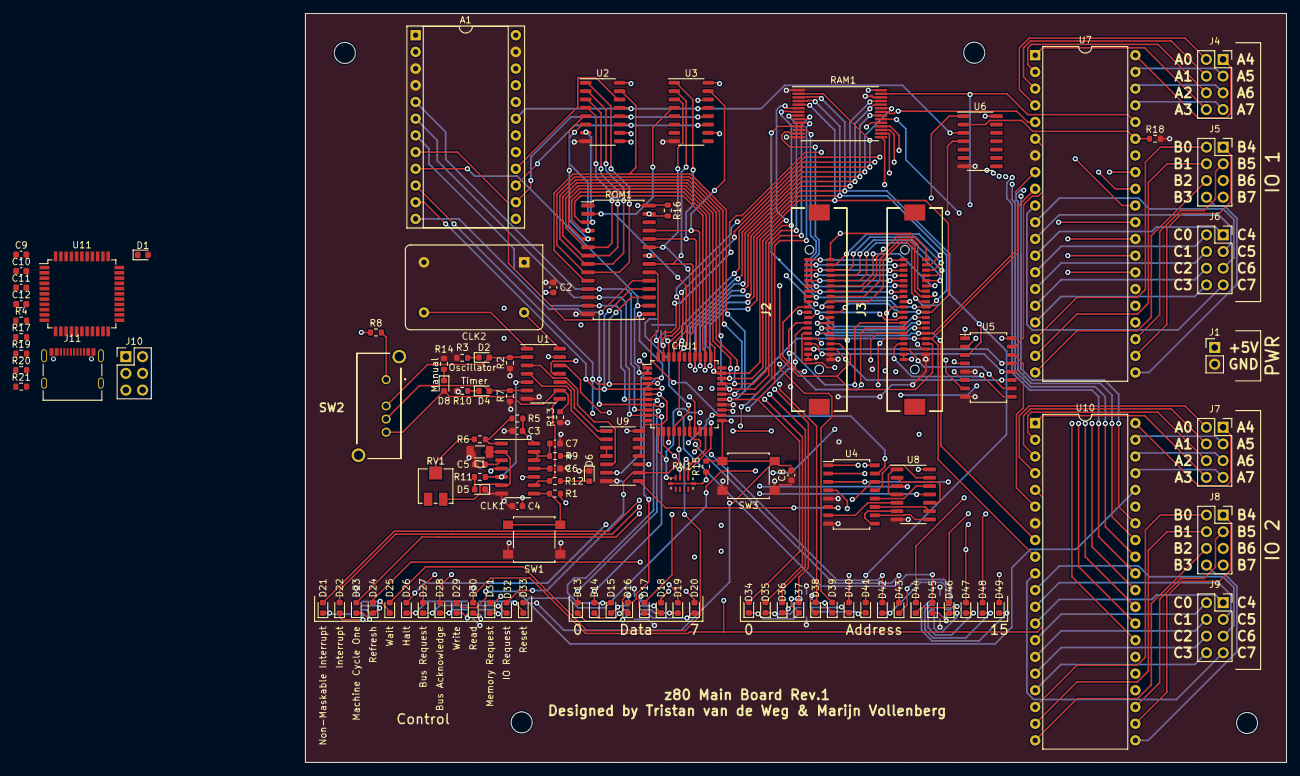
[picture p18: board z80.kicad_pcb from above]

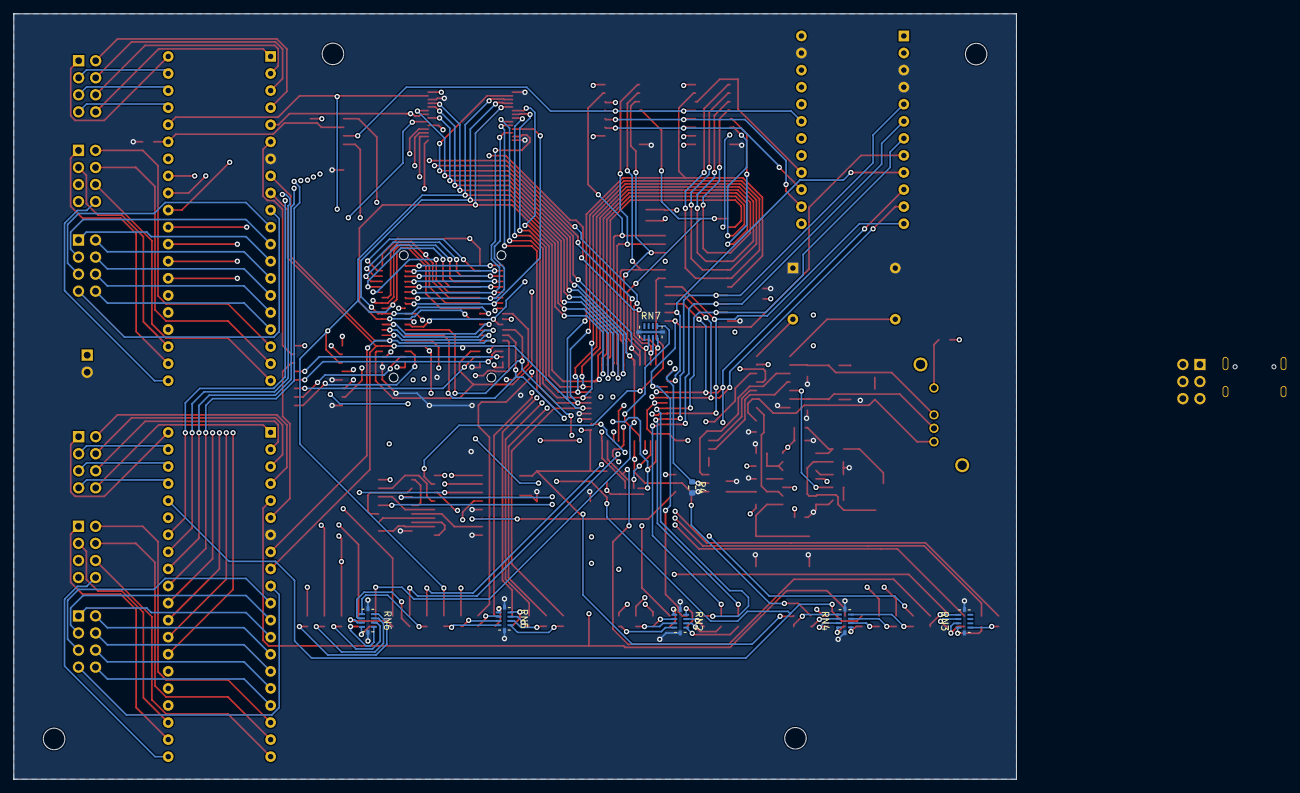
[picture p19: board z80.kicad_pcb from below]

Board: 4 copper layers, 149.2 x 113.9 mm, 116 parts (7 on the bottom side), 192 nets.

Parts:
A1: 32U4 Arduino; DIP-24_W15.24mm_Socket
C1: 1uF; C_1206_3216Metric
C2, C3, C4, C5, C6, C7: 0.1uF; C_0603_1608Metric
C8, C11, C12: 1uF; C_0603_1608Metric
C9, C10: 22pF; C_0603_1608Metric
CLK1: NE556; SOIC-14_3.9x8.7mm_P1.27mm
CLK2: TFT680; Oscillator_DIP-14
CPU1: Z84C0010AEG; LQFP-44_10x10mm_P0.8mm
D1: Red; LED_0603_1608Metric
D2, D4, D5, D6, D8: LED_Blue; LED_0603_1608Metric
D13, D14, D15, D16, D17, D18, D19, D20, D34, D35, D36, D37, D38, D39, D40, D41, D42, D43, D44, D45, D46, D47, D48, D49: LED_Yellow; LED_0603_1608Metric
D21, D22, D23, D24, D25, D26, D27, D28, D29, D30, D31, D32, D33: LED_Red; LED_0603_1608Metric
J1: PinHeader_Female01x02; PinHeader_1x02_P2.54mm_Vertical
J2, J3: PinHeader_Female16x02; FX2740S08SV
J4, J5, J6, J7, J8, J9: PinHeader_Female04x02; PinSocket_2x04_P2.54mm_Vertical
J10: Conn_02x03_Counter_Clockwise; PinHeader_2x03_P2.54mm_Vertical
J11: USB_C_Receptacle_USB2.0; USB_C_Receptacle_Palconn_UTC16-G
R1, R3, R5, R6, R8, R10, R14, R15, R21: 1K; R_0603_1608Metric
R2, R4, R4#2, R7, R11, R12, R13, R16, R18, R20: 10K; R_0603_1608Metric
R9: 2M; R_0603_1608Metric
R17, R19: 22R; R_0603_1608Metric
RAM1: HM62256BLP; TSOP-I-28_11.8x8mm_P0.55mm
RN1, RN2, RN3, RN4, RN5, RN6, RN7: EXB-D10C102J; EXB-D10C103J
ROM1: AT28C64B-15SU; SOIC-28W_7.5x17.9mm_P1.27mm
RV1: 1M; Potentiometer_Vishay_TS53YJ_Vertical
SW1, SW3: SW_Push; SW_SPST_B3S-1000
SW2: SW_SP3T; MHS133G04
U1, U8: 4081; SO-14_3.9x8.65mm_P1.27mm
U2, U3: 74HC595; SO-16_3.9x9.9mm_P1.27mm
U4, U5: SN74HC138N; SOIC-16W_5.3x10.2mm_P1.27mm
U6: 4069; SOIC-14_3.9x8.7mm_P1.27mm
U7, U10: 82C55A; DIP-40_W15.24mm
U9: 74LS32; SOIC-14_3.9x8.7mm_P1.27mm
U11: ATmega32U4RC-A; TQFP-44_10x10mm_P0.8mm

Connections:
+5V: A1.4 (+5V), C2.2, C3.2, C4.2, CLK1.4 (R), CLK1.10 (R), CLK1.14 (VCC), CLK2.14 (Vcc), CPU1.6 (VCC), D1.2 (A), J1.1, J2.19, J2.20, J3.19, J3.20, J10.2, R1.1, R4.1, R5.1, R8.1, R9.1, R15.2, R16.1, R20.2, RAM1.28 (VCC), RN1.1 (common), ROM1.28 (VCC), U1.14 (VDD), U2.10 (~SRCLR), U2.16 (VCC), U3.10 (~SRCLR), U3.16 (VCC), U4.16 (VCC), U5.16 (VCC), U6.14 (VDD), U7.26 (VCC), U8.14 (VDD), U9.14 (VCC), U10.26 (VCC), U11.14 (VCC), U11.24 (AVCC), U11.34 (VCC), U11.44 (AVCC)
/A0: CPU1.27 (A0), D34.2 (A), J2.36, J3.36, RAM1.10 (A0), ROM1.10 (A0), U2.15 (QA), U7.9 (A0), U10.9 (A0)
/A1: CPU1.28 (A1), D35.2 (A), J2.35, J3.35, RAM1.9 (A1), ROM1.9 (A1), U2.1 (QB), U7.8 (A1), U10.8 (A1)
/A2: CPU1.29 (A2), D36.2 (A), J2.34, J3.34, RAM1.8 (A2), ROM1.8 (A2), U2.2 (QC)
/A3: CPU1.30 (A3), D37.2 (A), J2.33, J3.33, RAM1.7 (A3), ROM1.7 (A3), U2.3 (QD)
/A4: CPU1.31 (A4), D38.2 (A), J2.32, J3.32, RAM1.6 (A4), ROM1.6 (A4), U2.4 (QE)
/A5: CPU1.32 (A5), D39.2 (A), J2.31, J3.31, RAM1.5 (A5), ROM1.5 (A5), U2.5 (QF), U5.1 (A)
/A6: CPU1.34 (A6), D40.2 (A), J2.30, J3.30, RAM1.4 (A6), ROM1.4 (A6), U2.6 (QG), U5.2 (B)
/A7: CPU1.35 (A7), D41.2 (A), J2.29, J3.29, RAM1.3 (A7), ROM1.3 (A7), U2.7 (QH), U5.3 (C)
/A8: CPU1.36 (A8), D42.2 (A), J2.28, J3.28, RAM1.25 (A8), ROM1.25 (A8), U3.15 (QA)
/A9: CPU1.37 (A9), D43.2 (A), J2.27, J3.27, RAM1.24 (A9), ROM1.24 (A9), U3.1 (QB)
/A10: CPU1.38 (A10), D44.2 (A), J2.26, J3.26, RAM1.21 (A10), ROM1.21 (A10), U3.2 (QC)
/A11: CPU1.40 (A11), D45.2 (A), J2.25, J3.25, RAM1.23 (A11), ROM1.23 (A11), U3.3 (QD)
/A12: CPU1.41 (A12), D46.2 (A), J2.24, J3.24, RAM1.2 (A12), ROM1.2 (A12), U3.4 (QE)
/A13: CPU1.42 (A13), D47.2 (A), J2.23, J3.23, RN7.7 (R6), U4.1 (A)
/A14: CPU1.43 (A14), D48.2 (A), J2.22, J3.22, RN7.8 (R7), U4.2 (B)
/A15: CPU1.44 (A15), D49.2 (A), J2.21, J3.21, RN7.9 (R8), U4.3 (C)
/AdjClk: CLK1.5 (Q), R11.2, U1.5
/AdjOUT: U1.4, U9.2
/BUSACK: A1.5 (A3), CPU1.20 (~BUSACK), D28.2 (A)
/BUSRQ: A1.12 (D10), CPU1.22 (~BUSRQ), D27.2 (A), RN1.2 (R1)
/D0: A1.20 (D2), CPU1.9 (D0), D13.2 (A), J2.8, J3.8, RAM1.11 (Q0), ROM1.11 (I/O0), U7.34 (D0), U10.34 (D0)
/D1: A1.19 (D3), CPU1.10 (D1), D14.2 (A), J2.7, J3.7, RAM1.12 (Q1), ROM1.12 (I/O1), U7.33 (D1), U10.33 (D1)
/D2: A1.18 (D4), CPU1.7 (D2), D15.2 (A), J2.6, J3.6, RAM1.13 (Q2), ROM1.13 (I/O2), U7.32 (D2), U10.32 (D2)
/D3: A1.17 (D5), CPU1.3 (D3), D16.2 (A), J2.5, J3.5, RAM1.15 (Q3), ROM1.15 (I/O3), U7.31 (D3), U10.31 (D3)
/D4: A1.16 (D6), CPU1.2 (D4), D17.2 (A), J2.4, J3.4, RAM1.16 (Q4), ROM1.16 (I/O4), U7.30 (D4), U10.30 (D4)
/D5: A1.15 (D7), CPU1.4 (D5), D18.2 (A), J2.3, J3.3, RAM1.17 (Q5), ROM1.17 (I/O5), U7.29 (D5), U10.29 (D5)
/D6: A1.14 (D8), CPU1.5 (D6), D19.2 (A), J2.2, J3.2, RAM1.18 (Q6), ROM1.18 (I/O6), U7.28 (D6), U10.28 (D6)
/D7: A1.13 (D9), CPU1.8 (D7), D20.2 (A), J2.1, J3.1, RAM1.19 (Q7), ROM1.19 (I/O7), U7.27 (D7), U10.27 (D7)
/EXT-CS: J2.37, J3.37, U1.11
/EXT-IO1-CS: J2.18, U5.13 (Y2)
/EXT-IO2-CS: J2.17, U5.12 (Y3)
/EXT-IO3-CS: J2.38, U5.11 (Y4)
/EXT-IO4-CS: J3.18, U5.10 (Y5)
/EXT-IO5-CS: J3.17, U5.9 (Y6)
/EXT-IO6-CS: J3.38, U5.7 (Y7)
/FstClk: CLK2.8 (OUT), U1.1
/FstOUT: U1.3, U9.5
/HALT: CPU1.14 (~HALT), D26.2 (A)
/INT: CPU1.12 (~INT), D22.2 (A), J2.14, J3.14, RN1.5 (R4)
/IO1-CS: U5.15 (Y0), U7.6 (~CS)
/IO2-CS: U5.14 (Y1), U10.6 (~CS)
/IOREQ: U4.6 (G1), U5.4 (~G2A), U9.8
/IORQ: CPU1.16 (~IORQ), D32.2 (A), J2.10, J3.10, U9.9
/M1: CPU1.24 (~M1), D23.2 (A)
/MISO: J10.1, U11.11 (PB3)
/MOSI: J10.4, U11.10 (PB2)
/MREQ: CPU1.15 (~MREQ), D31.2 (A), J2.11, J3.11, RN7.2 (R1), U4.4 (~G2A), U5.6 (G1)
/ManClk: CLK1.9 (Q), R12.1, U1.8
/ManOUT: U1.10, U9.1
/NMI: CPU1.13 (~NMI), D21.2 (A), J2.15, J3.15, RN1.4 (R3)
/PROG-OE: A1.6 (A2), R20.1, U2.13 (~OE), U3.13 (~OE), U6.3
/PROG-WR: A1.7 (A1), R16.2, ROM1.27 (~WE)
/ProgReset: J10.5, R4.2, U11.13 (~RESET)
/RAM1-CS: RAM1.20 (~CS), U4.14 (Y1)
/RD: A1.8 (A0), CPU1.18 (~RD), D30.2 (A), J2.12, J3.12, RAM1.22 (~OE), ROM1.22 (~OE), U7.5 (~RD), U10.5 (~RD)
/RFSH: CPU1.25 (~RFSH), D24.2 (A)
/ROM1-CS: ROM1.20 (~CE), U4.15 (Y0)
/RST: C8.2, CPU1.23 (~RESET), D33.2 (A), J2.9, J3.9, R15.1, SW3.2, U6.1
/RST-INV: R18.1, U6.2, U7.35 (RESET), U10.35 (RESET)
/SPISCK: J10.3, U11.9 (PB1)
/USB-D+: J11.A6 (D+), J11.B6 (D+), R17.1
/USB-D-: J11.A7 (D-), J11.B7 (D-), R19.1
/VBUS: C12.2, J11.A4 (VBUS), J11.A9 (VBUS), J11.B4 (VBUS), J11.B9 (VBUS), U11.2 (UVCC), U11.7 (VBUS)
/WAIT: CPU1.21 (~WAIT), D25.2 (A), J2.16, J3.16, RN1.3 (R2)
/WR: CPU1.19 (~WR), D29.2 (A), J2.13, J3.13, RAM1.27 (~WE), U7.36 (~WR), U10.36 (~WR)
Clock: CPU1.1 (~CLK), R4#2.1, U9.6
GND: A1.2 (GND), A1.21 (GND), A1.22 (GND), C1.2, C2.1, C3.1, C4.1, C5.2, C6.2, C7.1, C8.1, C9.2, C10.2, C11.2, C12.1, CLK1.7 (GND), CLK2.1 (EN), CLK2.7 (GND), CPU1.26 (GND), D5.1 (K), D6.1 (K), J1.2, J2.39, J2.40, J3.39, J3.40, J10.6, J11.A1 (GND), J11.A12 (GND), J11.B1 (GND), J11.B12 (GND), J11.S1 (SHIELD), R2.1, R3.2, R4#2.2, R7.1, R10.2, R13.1, R14.2, R18.2, RAM1.1 (A14), RAM1.14 (GND), RAM1.26 (A13), RN2.1 (common), RN3.1 (common), RN4.1 (common), RN5.1 (common), RN6.1 (common), RN7.1 (common), ROM1.14 (GND), SW1.1, SW3.1, U1.7 (VSS), U2.8 (GND), U3.8 (GND), U4.5 (~G2B), U4.8 (GND), U5.5 (~G2B), U5.8 (GND), U6.7 (VSS), U7.7 (GND), U8.7 (VSS), U9.7 (GND), U10.7 (GND), U11.5 (UGND), U11.15 (GND), U11.23 (GND), U11.33 (~HWB/PE2), U11.35 (GND), U11.43 (GND)
unnamed: A1.10 (D14), U2.11 (SRCLK), U3.11 (SRCLK)
unnamed: A1.9 (D15), U2.14 (SER)
unnamed: A1.11 (D16), U2.12 (RCLK), U3.12 (RCLK)
unnamed: C5.1, CLK1.3 (CV)
unnamed: CLK1.1 (DIS), R5.2, R6.2
unnamed: C1.1, CLK1.2 (THR), CLK1.6 (TR), RV1.1
unnamed: C6.1, CLK1.11 (CV)
unnamed: C7.2, CLK1.12 (THR), CLK1.13 (DIS), R9.2
unnamed: CLK1.8 (TR), R1.2, SW1.2
unnamed: D1.1 (K), R21.1
unnamed: D2.2 (A), R2.2, SW2.1, U1.2
unnamed: D2.1 (K), R3.1
unnamed: D4.2 (A), R7.2, SW2.3, U1.6
unnamed: D4.1 (K), R10.1
unnamed: D5.2 (A), R11.1
unnamed: D6.2 (A), R12.2
unnamed: D8.2 (A), R13.2, SW2.4, U1.9
unnamed: D8.1 (K), R14.1
unnamed: D13.1 (K), RN2.2 (R1)
unnamed: D14.1 (K), RN2.3 (R2)
unnamed: D15.1 (K), RN2.4 (R3)
unnamed: D16.1 (K), RN2.5 (R4)
unnamed: D17.1 (K), RN2.6 (R5)
unnamed: D18.1 (K), RN2.7 (R6)
unnamed: D19.1 (K), RN2.8 (R7)
unnamed: D20.1 (K), RN2.9 (R8)
unnamed: D21.1 (K), RN3.6 (R5)
unnamed: D22.1 (K), RN3.5 (R4)
unnamed: D23.1 (K), RN3.4 (R3)
unnamed: D24.1 (K), RN3.3 (R2)
unnamed: D25.1 (K), RN3.2 (R1)
unnamed: D26.1 (K), RN4.9 (R8)
unnamed: D27.1 (K), RN4.8 (R7)
unnamed: D28.1 (K), RN4.7 (R6)
unnamed: D29.1 (K), RN4.6 (R5)
unnamed: D30.1 (K), RN4.5 (R4)
unnamed: D31.1 (K), RN4.4 (R3)
unnamed: D32.1 (K), RN4.3 (R2)
unnamed: D33.1 (K), RN4.2 (R1)
unnamed: D34.1 (K), RN5.2 (R1)
unnamed: D35.1 (K), RN5.3 (R2)
unnamed: D36.1 (K), RN5.4 (R3)
unnamed: D37.1 (K), RN5.5 (R4)
unnamed: D38.1 (K), RN5.6 (R5)
unnamed: D39.1 (K), RN5.7 (R6)
unnamed: D40.1 (K), RN5.8 (R7)
unnamed: D41.1 (K), RN5.9 (R8)
unnamed: D42.1 (K), RN6.2 (R1)
unnamed: D43.1 (K), RN6.3 (R2)
unnamed: D44.1 (K), RN6.4 (R3)
unnamed: D45.1 (K), RN6.5 (R4)
unnamed: D46.1 (K), RN6.6 (R5)
unnamed: D47.1 (K), RN6.7 (R6)
unnamed: D48.1 (K), RN6.8 (R7)
unnamed: D49.1 (K), RN6.9 (R8)
unnamed: J4.1, U7.40 (PA4)
unnamed: J4.2, U7.4 (PA0)
unnamed: J4.3, U7.39 (PA5)
unnamed: J4.4, U7.3 (PA1)
unnamed: J4.5, U7.38 (PA6)
unnamed: J4.6, U7.2 (PA2)
unnamed: J4.7, U7.37 (PA7)
unnamed: J4.8, U7.1 (PA3)
unnamed: J5.1, U7.22 (PB4)
unnamed: J5.2, U7.18 (PB0)
unnamed: J5.3, U7.23 (PB5)
unnamed: J5.4, U7.19 (PB1)
unnamed: J5.5, U7.24 (PB6)
unnamed: J5.6, U7.20 (PB2)
unnamed: J5.7, U7.25 (PB7)
unnamed: J5.8, U7.21 (PB3)
unnamed: J6.1, U7.13 (PC4)
unnamed: J6.2, U7.14 (PC0)
unnamed: J6.3, U7.12 (PC5)
unnamed: J6.4, U7.15 (PC1)
unnamed: J6.5, U7.11 (PC6)
unnamed: J6.6, U7.16 (PC2)
unnamed: J6.7, U7.10 (PC7)
unnamed: J6.8, U7.17 (PC3)
unnamed: J7.1, U10.40 (PA4)
unnamed: J7.2, U10.4 (PA0)
unnamed: J7.3, U10.39 (PA5)
unnamed: J7.4, U10.3 (PA1)
unnamed: J7.5, U10.38 (PA6)
unnamed: J7.6, U10.2 (PA2)
unnamed: J7.7, U10.37 (PA7)
unnamed: J7.8, U10.1 (PA3)
unnamed: J8.1, U10.22 (PB4)
unnamed: J8.2, U10.18 (PB0)
unnamed: J8.3, U10.23 (PB5)
unnamed: J8.4, U10.19 (PB1)
unnamed: J8.5, U10.24 (PB6)
unnamed: J8.6, U10.20 (PB2)
unnamed: J8.7, U10.25 (PB7)
unnamed: J8.8, U10.21 (PB3)
unnamed: J9.1, U10.13 (PC4)
unnamed: J9.2, U10.14 (PC0)
unnamed: J9.3, U10.12 (PC5)
unnamed: J9.4, U10.15 (PC1)
unnamed: J9.5, U10.11 (PC6)
unnamed: J9.6, U10.16 (PC2)
unnamed: J9.7, U10.10 (PC7)
unnamed: J9.8, U10.17 (PC3)
unnamed: R6.1, RV1.2
unnamed: R8.2, SW2.2
unnamed: U1.12, U8.3
unnamed: U1.13, U8.11
unnamed: U2.9 (QH'), U3.14 (SER)
unnamed: U4.13 (Y2), U8.13
unnamed: U4.12 (Y3), U8.12
unnamed: U4.11 (Y4), U8.9
unnamed: U4.10 (Y5), U8.8
unnamed: U4.9 (Y6), U8.6
unnamed: U4.7 (Y7), U8.5
unnamed: U6.4, U9.10
unnamed: U8.1, U8.4
unnamed: U8.2, U8.10
unnamed: U9.3, U9.4
unnamed: R17.2, U11.4 (D+)
unnamed: R19.2, U11.3 (D-)
unnamed: R21.2, U11.8 (PB0)
unnamed: C11.1, U11.6 (UCAP)
unnamed: C9.1, U11.17 (XTAL1)
unnamed: C10.1, U11.16 (XTAL2)
