tristanvandeweg/z80/(commit log)

2021-10-26 * Added Arduino Programmer code, Schematic changes
    [z80.sch]
2021-11-04 first assembly test and assembler added
2021-11-28 Added python programmer interface
    [z80.sch]
2021-12-01 schematic changes
    [z80.sch]
2022-04-05 Schematic & eeprom programmer changes
    [z80.kicad_pcb]
2022-04-27 schematic and pcb changes
    [z80.kicad_pcb, z80.kicad_sch]
2022-11-03 cleaned up files, added script to launch programming tool
    [familylist_refdes.csv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]
2022-11-03 Delete z80Computer-v0.1-v1.1.pdf
    moved to z80/plots/schematic
2022-11-03 Delete z80Computer-v0.2.pdf
    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
2022-11-03 Delete z80R1.0Clk.pdf
    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
2022-11-03 Delete KiCAD directory
    moved to z80/
2023-01-10 Fixed an issue with displaying information
    [programmer.py]
2023-01-11 added gitignore, program changes
    [programmer.py.cfg]
2023-01-11 Implemented config parsing & updated .gitignore
    [programmer.py.cfg]
2023-04-17 OS asm, repo cleanup
    [FlashCartridge.kicad_sch, programmer.py.cfg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]
2023-05-11 Schematic changes, test script
    [FlashCartridge.kicad_sch, programmer.py.cfg, z80.csv, z80.kicad_pcb, z80.kicad_sch]
2023-05-14 Schematic cahnges, PCB changes, test asm changes
    [perfboardCard.kicad_pcb, perfboardCard.kicad_sch, z80.kicad_pcb, z80.kicad_sch]
2023-10-04 progress on programmer interface
    [programmer.py.cfg]
2023-11-30 Board revision 1
    [perfboardCard.kicad_pcb, z80.kicad_pcb, z80.kicad_sch]
2023-11-30 added custom character sheet and worked on _PrintB
    [custom_pcb.kicad_pcb, custom_pcb.kicad_sch]
2023-12-14 display control changes
    [Relay Schematic.kicad_sch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]
2024-01-03 Schematic/code changes, updated to 2024
    [IO_LCD_Adapter.kicad_pcb, IO_LCD_Adapter.kicad_sch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]
2024-01-03 Move perfboardcard
    [perfboardCard-B_Cu.gbr, perfboardCard-B_Mask.gbr, perfboardCard-B_Paste.gbr, perfboardCard-B_Silkscreen.gbr, perfboardCard-Edge_Cuts.gbr, perfboardCard-F_Cu.gbr, perfboardCard-F_Mask.gbr, perfboardCard-F_Paste.gbr]
2024-01-11 Assembly code changes
2024-01-12 Big progress on assembly
2024-01-24 schematic updates, assembly progress
    [ROM_Card.kicad_pcb, ROM_Card.kicad_sch, z80.kicad_sch]
2024-03-15 finished v2 of hardware, updated eeprom prog pins
    [IO_LED_Stick-B_Cu.gbr, IO_LED_Stick-B_Mask.gbr, IO_LED_Stick-B_Paste.gbr, IO_LED_Stick-B_Silkscreen.gbr, IO_LED_Stick-Edge_Cuts.gbr, IO_LED_Stick-F_Cu.gbr, IO_LED_Stick-F_Mask.gbr, IO_LED_Stick-F_Paste.gbr]
